Montufar/Hexagro_MBV2.1/README.md

# Hexagro_MBV2.1
Schematic, BOM and PCB layout of V2.1 Motherboard
