Montufar/Hexagro_MBV2.1/motherBoard_V2.xlsx

Sheet: Motherboard
Item | Qty | Reference(s) | Value | LibPart | Footprint | Mouser Code |  | x1
1 | 1 | AFF1 | HDSP-7xxx-A | display:HDSP-7xxx-A | Displays_7-Segment:HDSP-78xx | 630-HDSP-7803-JK000 (https://eu.mouser.com/ProductDetail/Broadcom-Avago/HDSP-7803-JK000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) |  | 1
2 | 6 | C1, C12, C13, C23, C24, C25 | 1uF | device:C | Capacitors_SMD:C_0603 | 81-GRM188C80G105MA1D (https://eu.mouser.com/ProductDetail/Murata-Electronics/GRM188C80G105MA01D) |  | 6
3 | 2 | C2, C3 | 18pF | device:C | Capacitors_SMD:C_0603 | 77-VJ0603A180JXQCBC (https://eu.mouser.com/ProductDetail/Vishay-Vitramon/VJ0603A180JXQCW1BC) |  | 2
4 | 1 | C4 | 680uF | device:CP1 | Capacitors_SMD:CP_Elec_10x10.5 | 667-EEE-FT1V681UP |  | 1
5 | 1 | C5 | 220uF | device:CP1 | Capacitors_SMD:CP_Elec_10x10.5 | 80-EDK227M010A9HAA |  | 1
6 | 6 | C6, C7, C8, C9, C10, C11 | 100nF | device:C | Capacitors_SMD:C_0603 | 603-CC603ZRY5V7BB104 (https://eu.mouser.com/ProductDetail/Yageo/CC0603ZRY5V7BB104) |  | 6
7 | 6 | C14, C16, C17, C19, C20, C22 | 1nF | device:C | Capacitors_SMD:C_0603 | 710-885012206034 (https://eu.mouser.com/ProductDetail/Wurth-Electronics/885012206034) |  | 6
8 | 3 | C15, C18, C21 | 10nF | device:C | Capacitors_SMD:C_0603 | 710-885012206065 (https://eu.mouser.com/ProductDetail/Wurth-Electronics/885012206065) |  | 3
9 | 1 | CON1 | AVR-ISP-6 | atmel:AVR-ISP-6 | Pin_Headers:Pin_Header_Straight_2x03_Pitch2.54mm | 571-103777-3 (https://eu.mouser.com/ProductDetail/TE-Connectivity-AMP/103777-3) |  | 1
10 | 34 | D1, D6, D7, D8, D9, D10, D11, D12, D13, D14, D15, D16, D17, D18, D19, D20, D21, D22, D23, D24, D25, D26, D27, D28, D29, D30, D31, D32, D34, D35, D36, D38, D39, D40 | LED | device:LED | LEDs:LED_0603 | 710-150060RS75000 |  | 34
11 | 1 | D2 | D_TVS_24V | device:D_TVS | Diodes_SMD:D_SMA | - |  | 1
12 | 3 | D3, D4, D5 | D | device:D | Diodes_SMD:D_SMA | 755-RB080LAM-30TR (https://eu.mouser.com/ProductDetail/ROHM-Semiconductor/RB080LAM-30TR) |  | 3
13 | 4 | F1, F2, F3, F7 | F | device:Fuse | Fuse_Holders_and_Fuses:Fuseholder5x20_horiz_open_universal_Type-III | 693-0031.8201 |  | 4
14 | 1 | F5 | 1A | device:Fuse | Fuse_Holders_and_Fuses:Fuse_SMD1206_Reflow | 650-0603SFS100F/32-2 (https://eu.mouser.com/ProductDetail/Littelfuse/0603SFS100F-32-2) |  | 1
15 | 1 | F6 | 3A | device:Fuse | Fuse_Holders_and_Fuses:Fuse_SMD1206_Reflow | 650-0603SFS300F/32-2 (https://eu.mouser.com/ProductDetail/Littelfuse/0603SFS300F-32-2) |  | 1
16 | 1 | J1 | Conn_LEDs | conn:Conn_02x02_Counter_Clockwise | Connectors_Molex:Molex_MiniFit-JR-5569-04A2_2x02x4.20mm_Angled | 538-39-30-0040 (https://eu.mouser.com/ProductDetail/Molex/39-30-0040) | 538-39-01-2046 | 1
17 | 2 | J2, J4 | Conn_Hyd_1 | conn:Conn_02x07_Top_Bottom | Connectors_Molex:Molex_MiniFit-JR-5569-14A2_2x07x4.20mm_Angled | 538-39-30-1140 (https://eu.mouser.com/ProductDetail/Molex/39-30-1140) | 538-15-06-0146 | 2
18 | 1 | J3 | Conn_RPi3 | conn:Conn_02x20_Odd_Even | Pin_Headers:Pin_Header_Straight_2x20_Pitch2.54mm | 517-929975-01-20 (https://eu.mouser.com/ProductDetail/3M-Electronic-Solutions-Division/929975-01-20) |  | 1
19 | 2 | J5, J9 | Conn_01x03 | conn:Conn_01x03 | Pin_Headers:Pin_Header_Straight_1x03_Pitch2.54mm | 571-2828343 |  | 2
20 | 8 | J6, J7, J8, J10, J11, J12, M1, JQ5 | Conn_01x02 | conn:Conn_01x02 | Pin_Headers:Pin_Header_Straight_2x01_Pitch2.54mm | 571-282834-2 |  | 8
21 | 1 | L1 | 33uH | device:L | Inductors_SMD:L_12x12mm_h8mm | 994-MSS1278-333MLD (https://eu.mouser.com/ProductDetail/Coilcraft/MSS1278-333MLD) |  | 1
22 | 3 | Q1, Q2, Q3 | BSS138 | transistors:BSS138 | TO_SOT_Packages_SMD:SOT-23 | 771-BSS138P215 (https://eu.mouser.com/ProductDetail/Nexperia/BSS138P215?qs=sGAEpiMZZMuW3D0gRv32gn9EhwRhF9cb) |  | 3
23 | 1 | Q4 | 2N7000 | transistors:2N7000 | TO_SOT_Packages_SMD:SOT-23 | 621-DMN2230UQ-7 (https://eu.mouser.com/ProductDetail/Diodes-Incorporated/DMN2230UQ-7) |  | 1
24 | 1 | Q5 | TEPT4400 | opto:BP103B | Pin_Headers:Pin_Header_Straight_2x01_Pitch2.54mm | 782-TEPT4400 |  | 1
25 | 3 | R1 | 10m | device:R | Arduino:OARS1 | 66-OARS3R010FLF (https://eu.mouser.com/ProductDetail/IRC-TT-Electronics/OARS3R010FLF) |  | 3
26 | 2 | R2, R3 | 50m | device:R | Arduino:OARS1 | 660-SL3TTE50L0F (https://eu.mouser.com/ProductDetail/KOA-Speer/SL3TTE50L0F) |  | 2
27 | 27 | R4, R19, R20, R21, R22, R23, R24, R25, R26, R27, R28, R29, R30, R31, R32, R33, R34, R35, R36, R39, R40, R42, R43, R59, R61, R62, R63 | 2k2 | device:R | Resistors_SMD:R_0603 | 660-SG73G1JTTD2201D (https://eu.mouser.com/ProductDetail/KOA-Speer/SG73G1JTTD2201D) |  | 27
28 | 29 | R5, R6, R7, R8, R9, R10, R11, R37, R38, R44, R46, R49, R50, R51, R65, R66, R67, R68, R69, R70, R71, R73, R74, R75, R76, R77, R78, R79, R80 | 10k | device:R | Resistors_SMD:R_0603 | 71-RCG060310K0JNEA (https://eu.mouser.com/ProductDetail/Vishay-Draloric/RCG060310K0JNEA) |  | 29
29 | 15 | R12, R13, R14, R15, R16, R17, R18, R48, R52, R53, R54, R55, R56, R57, R58 | 330 | device:R | Resistors_SMD:R_0603 | 755-ESR03EZPJ331 (https://eu.mouser.com/ProductDetail/ROHM-Semiconductor/ESR03EZPJ331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) |  | 15
30 | 3 | R41, R60, R64 | 1M | device:R | Resistors_SMD:R_0603 | 667-ERJ-PA3J105V (https://eu.mouser.com/ProductDetail/Panasonic/ERJ-PA3J105V) |  | 3
31 | 2 | R45, R47 | 100 | device:R | Resistors_SMD:R_0603 | 603-AC0603FR-13100RL (https://eu.mouser.com/ProductDetail/Yageo/AC0603FR-13100RL) |  | 2
32 | 1 | R72 | 22k | device:R | Resistors_SMD:R_0603 | 71-RCG060322K0JNEA (https://eu.mouser.com/ProductDetail/Vishay-Draloric/RCG060322K0JNEA) |  | 1
33 | 3 | R81, R82, R83 | 100k | device:R | Resistors_SMD:R_0603 | 71-RCA0603100KJNEC (https://eu.mouser.com/ProductDetail/Vishay-Draloric/RCA0603100KJNEC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) |  | 3
34 | 3 | SW1, SW2, SW3 | SW_Push | switches:SW_Push | Buttons_Switches_SMD:SW_SPST_B3SL-1002P | 653-B3SL-1002P |  | 3
35 | 4 | TH1, TH2, TH3, TH4 | Thermistor_NTC | device:Thermistor_NTC | Resistors_SMD:R_0603 | 81-NCP18XH103J03RB (https://eu.mouser.com/ProductDetail/Murata-Electronics/NCP18XH103J03RB) |  | 4
36 | 1 | U2 | MAX485E | interface:MAX485E | Housings_SOIC:SO-8_5.3x6.2mm_Pitch1.27mm | 584-LTC1481CS8#PBF (https://eu.mouser.com/ProductDetail/Analog-Devices/LTC1481CS8PBF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) |  | 1
37 | 3 | U3, U4, U5 | TLE6230GP | motherBoard_V2.0-cache:TLE6230GP | Arduino:PG-DSO-36 | 726-TLE6230GP (https://eu.mouser.com/ProductDetail/Infineon-Technologies/TLE6230GP) |  | 3
38 | 1 | U6 | ATMEGA2560-16AU | atmel:ATMEGA2560-16AU | Housings_QFP:TQFP-100_14x14mm_Pitch0.5mm | 556-ATMEGA2560-16AU (https://eu.mouser.com/ProductDetail/Microchip-Technology-Atmel/ATmega2560-16AU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) |  | 1
39 | 1 | U7 | LM2596S-5 | Regulator_Switching:LM2596S-5 | TO_SOT_Packages_SMD:TO-263-5_TabPin3 | 926-LM2596SX-5.0NOPB (https://eu.mouser.com/ProductDetail/Texas-Instruments/LM2596SX-50-NOPB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) |  | 1
40 | 1 | U8 | INA4180A2IPWR | motherBoard_V2.0-cache:INA4180 | Housings_SSOP:TSSOP-14_4.4x5mm_Pitch0.65mm | 595-INA4180A2IPWR |  | 1
41 | 1 | U9 | MCP6004 | linear:MCP6004 | Housings_SOIC:SOIC-14_3.9x8.7mm_Pitch1.27mm | 579-MCP6004T-I/SL (https://eu.mouser.com/ProductDetail/Microchip-Technology/MCP6004T-I-SL) |  | 1
42 | 3 | U10, U11, U12 | AD8495 | motherBoard_V2.0-cache:AD8495 | Housings_SSOP:MSOP-8_3x3mm_Pitch0.65mm | 584-AD8495ARMZ-R7 (https://eu.mouser.com/ProductDetail/Analog-Devices/AD8495ARMZ-R7?qs=sGAEpiMZZMv9Q1JI0Mo%2ftbIZZET%2feT7H) |  | 3
43 | 1 | Y1 | 16 MHz | device:Crystal | Crystals:Crystal_SMD_0603-2pin_6.0x3.5mm | 520-16.0-18-23G-JGNT (https://eu.mouser.com/ProductDetail/ECS/ECS-160-18-23G-JGN-TR) |  | 1
44 | 3 | 1 A Fuse |  |  |  | 530-5VT1-R (https://eu.mouser.com/ProductDetail/Bel-Fuse/5VT-1-R) |  | 3
45 | 1 | 8 A Fuse |  |  |  | 530-5MF8-R (https://eu.mouser.com/ProductDetail/Bel-Fuse/5MF-8-R) |  | 1
46 | 1 | Raspberry Pi 3 |  |  |  | 358-6010602 (https://eu.mouser.com/ProductDetail/Raspberry-Pi/6010602) |  | 1
47 | 1 | uSD 32 Gb |  |  |  | - |  | 1
48 | 1 | fan |  |  |  | 562-FAD1-06020BSHW11 |  | 1
49 | 1 | box |  |  |  | 616-82407-01 (https://eu.mouser.com/ProductDetail/PacTec/82407-01-PT-10-ALUM) |  | 1
50 | 1 | dht11/22 |  |  |  | 485-386 (https://eu.mouser.com/ProductDetail/Adafruit/386?qs=sGAEpiMZZMsMyYRRhGMFNh01bQ8voJljBK9gPXpRcgg%3d) |  | 1
51 | 3 | thermocouples |  |  |  | 615-TP29 |  | 3
52 | 3 | FSR |  |  |  | 588-FSR01CE (https://eu.mouser.com/ProductDetail/Ohmite/FSR01CE) |  | 3
53 | 1 | Water pressure sensor |  |  |  | - |  | 1
54 | 1 | Minifit Jr 4 |  |  |  | 538-39-01-2040 |  | 1
55 | 2 | Minifit Jr 14 |  |  |  | 538-39-01-2140 (https://eu.mouser.com/ProductDetail/Molex/39-01-2140) |  | 2
56 | 30 | crimp male |  |  |  | 538-39-00-0078 (https://eu.mouser.com/ProductDetail/Molex/39-00-0078) |  | 30
57 | 1 | main switch |  |  |  | 691-DA100-BB-B |  | 1
 | 1 | solder paste |  |  |  | 474-TOL-12878 |  | 1

Sheet: LED Driver
Item | Qty | Reference(s) | Value | LibPart | Footprint | Mouser Code | x1
1 | 3 | C1, C2, C3 | 1uF | device:CP1 | Capacitors_SMD:C_0603 | 81-GRM188C80G105MA1D (https://eu.mouser.com/ProductDetail/Murata-Electronics/GRM188C80G105MA01D) | 3
2 | 3 | C4, C5, C6 | 3.3uF | device:CP1 | Capacitors_SMD:C_0603 | 810-C1608JB1V335M08C | 3
3 | 1 | C7 | 10uF | device:CP1 | Capacitors_Tantalum_SMD:CP_Tantalum_Case-R_EIA-2012-12_Reflow | 74-TMCMC1V106MTRF | 1
4 | 3 | C8, C11, C12 | 100nF | device:C | Capacitors_SMD:C_0603 | 603-CC603ZRY5V7BB104 (https://eu.mouser.com/ProductDetail/Yageo/CC0603ZRY5V7BB104) | 3
5 | 1 | C9 | 22nF | device:C | Capacitors_SMD:C_0603 | 710-885012206042 (https://eu.mouser.com/ProductDetail/Wurth-Electronics/885012206042) | 1
6 | 1 | C10 | 4.7uF | device:C | Capacitors_SMD:C_0603 | 810-CGB3B1X5R1A475MC (https://eu.mouser.com/ProductDetail/TDK/CGB3B1X5R1A475M055AC?qs=sGAEpiMZZMs0AnBnWHyRQAvc2asflqO5yVUq4hNDKGE%3d) | 1
7 | 1 | CON1 | AVR-ISP-6 | atmel:AVR-ISP-6 | Pin_Headers:Pin_Header_Straight_2x03_Pitch1.27mm | 649-67997-410HLF | 1
8 | 5 | D1, D2, D3, D4, D10 | D_Schottky | device:D_Schottky | Diodes_SMD:D_SOD-123 | 511-STPS2H100ZF (https://eu.mouser.com/ProductDetail/STMicroelectronics/STPS2H100ZF) | 5
9 | 1 | D5 | D_TVS | device:D_Zener | Diodes_SMD:D_SOD-123F | 652-SMAJ24CA-H | 1
10 | 4 | D6, D7, D8, D9 | NUP2105L | device:D_TVS_x2_AAC | TO_SOT_Packages_SMD:SOT-23 | 863-NUP2105LT1G (https://www.mouser.it/ProductDetail/ON-Semiconductor/NUP2105LT1G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) | 4
11 | 4 | F1, F2, F3, F4 | 0.5 A | device:Fuse | Resistors_SMD:R_0603 | 650-0603SFS100F/32-2 (https://www.mouser.it/ProductDetail/Littelfuse/0603SFS100F-32-2) | 4
12 | 1 | IC1 | ATMEGA48-A | HexCell-cache:ATMEGA48-A | Housings_QFP:TQFP-32_7x7mm_Pitch0.8mm | 556-ATMEGA48PB-AU (https://www.mouser.it/ProductDetail/Microchip-Technology-Atmel/ATMEGA48PB-AU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) | 1
13 | 1 | J1 | Conn_02x02_Top_Bottom | conn:Conn_02x02_Top_Bottom | Pin_Headers:Pin_Header_Straight_2x02_Pitch2.54mm | 649-67997-410HLF | 1
14 | 1 | J2 | Conn_02x04_Odd_Even | conn:Conn_02x04_Odd_Even | Pin_Headers:Pin_Header_Straight_2x04_Pitch2.54mm | 649-67997-410HLF | 1
15 | 2 | L1, L2 | 33nH | HexCell-cache:INDUCTOR | Resistors_SMD:R_1206 | 70-ILSB0805ERR33K (https://www.mouser.it/ProductDetail/Vishay-Dale/ILSB0805ERR33K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) | 2
16 | 3 | L3, L4, L5 | 33uH | device:L | Inductors_SMD:L_Abracon_ASPI-3012S | 994-ME3220-333KLB (https://www.mouser.it/ProductDetail/Coilcraft/ME3220-333KLB) | 3
17 | 1 | L6 | 4.7uH | device:L | Inductors_SMD:L_Abracon_ASPI-3012S | 994-ME3220-472MLB (https://www.mouser.it/ProductDetail/Coilcraft/ME3220-472MLB) | 1
18 | 5 | R1, R2, R3, R7, R9 | 10k | device:R | Resistors_SMD:R_0603 | 71-RCG060310K0JNEA (https://eu.mouser.com/ProductDetail/Vishay-Draloric/RCG060310K0JNEA) | 5
19 | 3 | R4, R5, R6 | 300m | device:R | Resistors_SMD:R_0805 | 667-ERJ-6DQJR30V | 3
20 | 1 | R8 | 100R | device:R | Resistors_SMD:R_0603 | 603-AC0603FR-13100RL (https://eu.mouser.com/ProductDetail/Yageo/AC0603FR-13100RL) | 1
21 | 1 | R10 | 28.7k | device:R | Resistors_SMD:R_0603 | 603-RC0603FR-1328K7L (https://www.mouser.it/ProductDetail/Yageo/RC0603FR-1328K7L?qs=sGAEpiMZZMvdGkrng054t8AJgcdMkx7xtkFTZBbxgCA%3d) | 1
22 | 1 | R11 | 150k | device:R | Resistors_SMD:R_0603 | 603-RC0603FR-07150KL (https://www.mouser.it/ProductDetail/Yageo/RC0603FR-07150KL) | 1
23 | 3 | U1, U2, U3 | AL8805 | HexCell-cache:AL8805 | TO_SOT_Packages_SMD:SOT-23-5 | 621-AL8805W5-7 | 3
24 | 1 | U4 | SP485EN-L/TR | HexCell-cache:MAX-485 | Housings_SOIC:SOIC-8_3.9x4.9mm_Pitch1.27mm | 584-LTC1481CS8#PBF (https://eu.mouser.com/ProductDetail/Analog-Devices/LTC1481CS8PBF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) | 1
25 | 1 | U5 | ACT4088 | HexCell-cache:ACT4088 | TO_SOT_Packages_SMD:SOT-23-6 | 107-ACT4088US-T (https://www.mouser.it/ProductDetail/Active-Semi/ACT4088US-T) | 1

Sheet: Shopping
Item | Reference(s) | Value | Mouser Code | Qty
 | AFF1 | 8 Segment Display | 630-HDSP-7803-JK000 (https://eu.mouser.com/ProductDetail/Broadcom-Avago/HDSP-7803-JK000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) | 2
 | C1, C12, C13, C23, C24, C25 | 1uF, 10V, 0603 | 81-GRM18R61A105MA61D (https://eu.mouser.com/ProductDetail/Murata-Electronics/GRM188R61A105MA61D) | 10 | tanks for smart low-sides and LPF for thermocouple circuits
 | C2, C3 | 18pF, 10V, 0603 | 77-VJ0603A180JXQCBC (https://eu.mouser.com/ProductDetail/Vishay-Vitramon/VJ0603A180JXQCW1BC) | 5 | for crystal oscillator
 | C4 | 680uF, 35V, 10x10.2mm | 667-EEE-FT1V681UP | 2 | input capacitor for step-down
 | C5 | 220uF, 10V, 10x10.2mm | 80-EDK227M010A9HAA | 2 | output capacitor for step-down
 | C6, C7, C8, C9, C10, C11 | 100nF, 10V, 0603 | 710-885012206020 (https://eu.mouser.com/ProductDetail/Wurth-Electronics/885012206020) | 10 | bypass for MCU and transceiver
 | C14, C16, C17, C19, C20, C22 | 1nF, 16V, 0603 | 710-885012206034 (https://eu.mouser.com/ProductDetail/Wurth-Electronics/885012206034) | 10 | input filter for thermocouples
 | C15, C18, C21 | 10nF, 25V, 0603 | 710-885012206065 (https://eu.mouser.com/ProductDetail/Wurth-Electronics/885012206065) | 10 | input filter for thermocouples
 | D1, D6, D7, D8, D9, D10, D11, D12, D13, D14, D15, D16, D17, D18, D19, D20, D21, D22, D23, D24, D25, D26, D27, D28, D29, D30, D31, D32, D34, D35, D36, D38, D39, D40 | Indicator LED | 710-150060RS75000 | 50 | indicator LEDs
 | D3, D4, D5 | Schottky, 5A, 30V, SOD-128 | 755-RB080LAM-30TR (https://eu.mouser.com/ProductDetail/ROHM-Semiconductor/RB080LAM-30TR) | 5 | step-down circuit diodes
 | F1, F2, F3, F7 | Fuse Holder, 5x20mm | 693-0031.8201 | 5 | fuse holders
 | F7, F1, F2 | 1A | 530-5VT1-R (https://eu.mouser.com/ProductDetail/Bel-Fuse/5VT-1-R) | 5 | 1A glass fuse 5x20mm
 | F3 | 8A | 530-5MF8-R (https://eu.mouser.com/ProductDetail/Bel-Fuse/5MF-8-R) | 5 | 8A glass fuse 5x20mm
 | F5 | 1A | 650-0603SFS100F/32-2 (https://eu.mouser.com/ProductDetail/Littelfuse/0603SFS100F-32-2) | 3 | step-down input fuse
 | F6 | 3A | 650-0603SFS300F/32-2 (https://eu.mouser.com/ProductDetail/Littelfuse/0603SFS300F-32-2) | 3 | step-down output fuse
 | J1 | Conn_LEDs | 538-39-30-0040 (https://eu.mouser.com/ProductDetail/Molex/39-30-0040) | 2 | minifit jr 2x2 header (male)
 | J2, J4 | Conn_Hyd_1 | 538-39-30-1140 (https://eu.mouser.com/ProductDetail/Molex/39-30-1140) | 4 | minifit jr 2x7 header (male)
 | J1 | Conn_LEDs | 538-39-01-2040 | 2 | minifit jr 2x2 receptacle housing (female)
 | J2, J4 | Conn_Hyd_1 | 538-39-01-2140 (https://eu.mouser.com/ProductDetail/Molex/39-01-2140) | 4 | minifit jr 2x14 receptacle housing (female)
 | J1, J2, J4 | crimp male | 538-39-00-0078 (https://eu.mouser.com/ProductDetail/Molex/39-00-0078) | 50 | minifit jr female crimp
 | J3 | Conn_RPi3 | 517-929975-01-20 (https://eu.mouser.com/ProductDetail/3M-Electronic-Solutions-Division/929975-01-20) | 2 | receptacle for raspberry pi
 | MPU1 | Raspberry Pi 3 | 358-RPI3-MODBP-BULK (https://eu.mouser.com/ProductDetail/Raspberry-Pi/RPI3-MODBP-BULK) | 1 | Raspberry Pi 3 B+
 | J5, J9 | Conn_01x03 | 571-2828343 | 3 | 3 inputs terminal block
 | J6, J7, J8, J10, J11, J12, M1, JQ5 | Conn_01x02 | 571-282834-2 | 10 | 2 inputs terminal block
 | L1 | 33uH, 3.1A, 12.3x12.3mm | 994-MSS1278-333MLD (https://eu.mouser.com/ProductDetail/Coilcraft/MSS1278-333MLD) | 2 | step-down inductor
 | Q1, Q2, Q3 | BSS138 | 771-BSS138P215 (https://eu.mouser.com/ProductDetail/Nexperia/BSS138P215?qs=sGAEpiMZZMuW3D0gRv32gn9EhwRhF9cb) | 5 | for 3.3V-to-5V level circuits
 | Q4 | DMN2230UQ-7 | 621-DMN2230UQ-7 (https://eu.mouser.com/ProductDetail/Diodes-Incorporated/DMN2230UQ-7) | 2 | fan driver MOSFET 20V N-Ch Enh FET 20Vdss 2.0A 7A 600mW
 | Q5 | TEPT4400 | 782-TEPT4400 | 2 | Ambient light sensor
 | R1 | 10m, 3W | 66-OARS3R010FLF (https://eu.mouser.com/ProductDetail/IRC-TT-Electronics/OARS3R010FLF) | 5 | current sense resistor, 10mOhm
 | R2, R3 | 50m | 660-SL3TTE50L0F (https://eu.mouser.com/ProductDetail/KOA-Speer/SL3TTE50L0F) | 2 | current sense resistor, 50mOhm, not correct size
 | R4, R19, R20, R21, R22, R23, R24, R25, R26, R27, R28, R29, R30, R31, R32, R33, R34, R35, R36, R39, R40, R42, R43, R59, R61, R62, R63 | 2k2 | 660-SG73G1JTTD2201D (https://eu.mouser.com/ProductDetail/KOA-Speer/SG73G1JTTD2201D) | 50 | indicator LED resistors for 24V signals
 | R5, R6, R7, R8, R9, R10, R11, R37, R38, R44, R46, R49, R50, R51, R65, R66, R67, R68, R69, R70, R71, R73, R74, R75, R76, R77, R78, R79, R80 | 10k | 71-RCG060310K0JNEA (https://eu.mouser.com/ProductDetail/Vishay-Draloric/RCG060310K0JNEA) | 50 | pull-up and pull-downs
 | R12, R13, R14, R15, R16, R17, R18, R48, R52, R53, R54, R55, R56, R57, R58 | 330 | 755-ESR03EZPJ331 (https://eu.mouser.com/ProductDetail/ROHM-Semiconductor/ESR03EZPJ331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) | 20 | indicator LED resistors for 5V signals
 | R41, R60, R64 | 1M | 667-ERJ-PA3J105V (https://eu.mouser.com/ProductDetail/Panasonic/ERJ-PA3J105V) | 5 | for thermocouple circuits
 | R45, R47 | 100 | 71-RCG0603100RFKEA (https://eu.mouser.com/ProductDetail/Vishay-Draloric/RCG0603100RFKEA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) | 5 | for fan driver and transceiver
 | R72 | 22k | 71-RCG060322K0JNEA (https://eu.mouser.com/ProductDetail/Vishay-Draloric/RCG060322K0JNEA) | 2 | for light sensor circuit
 | R81, R82, R83 | 100k | 71-RCA0603100KJNEC (https://eu.mouser.com/ProductDetail/Vishay-Draloric/RCA0603100KJNEC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) | 5 | LPF for thernocouple circuits
 | SW1, SW2, SW3 | SW_Push | 653-B3SL-1002P | 5 | buttons for test control
 | TH1, TH2, TH3, TH4 | Thermistor_NTC | 81-NCP18XH103J03RB (https://eu.mouser.com/ProductDetail/Murata-Electronics/NCP18XH103J03RB) | 5 | thermistors
 | U2 | SP485EN-L/TR | 701-SP485EN-L/TR (https://eu.mouser.com/ProductDetail/Exar/SP485EN-L-TR) | 2 | RS-485 transceiver
 | U3, U4, U5 | TLE6230GP | 726-TLE6230GP (https://eu.mouser.com/ProductDetail/Infineon-Technologies/TLE6230GP) | 6 | smart low-side drivers
 | U6 | ATMEGA2560-16AU | 556-ATMEGA2560-16AU (https://eu.mouser.com/ProductDetail/Microchip-Technology-Atmel/ATmega2560-16AU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) | 3 | main MCU
 | U7 | LM2596S-5 | 926-LM2596SX-5.0NOPB (https://eu.mouser.com/ProductDetail/Texas-Instruments/LM2596SX-50-NOPB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) | 2 | step-down driver
 | U8 | INA4180A2IPWR | 595-INA4180A2IPWR | 2 | current sense circuit
 | U9 | MCP6004 | 579-MCP6004T-I/SL (https://eu.mouser.com/ProductDetail/Microchip-Technology/MCP6004T-I-SL) | 2 | signal conditioning for sensors
 | U10, U11, U12 | AD8495 | 584-AD8495ARMZ-R7 (https://eu.mouser.com/ProductDetail/Analog-Devices/AD8495ARMZ-R7?qs=sGAEpiMZZMv9Q1JI0Mo%2ftbIZZET%2feT7H) | 5 | thermocouple instrumentation amplifier
 | Y1 | 16 MHz | 520-16.0-18-23G-JGNT (https://eu.mouser.com/ProductDetail/ECS/ECS-160-18-23G-JGN-TR) | 2 | crystal oscillator
 | A1 | fan | 562-FAD1-06020BSHW11 | 2 | 60x60x20mm fan, 5V, 900mW (0.18A) BLDC
 | box |  | 616-82407-01 (https://eu.mouser.com/ProductDetail/PacTec/82407-01-PT-10-ALUM) | 1 | box
 | dht11/22 |  | 485-386 (https://eu.mouser.com/ProductDetail/Adafruit/386?qs=sGAEpiMZZMsMyYRRhGMFNh01bQ8voJljBK9gPXpRcgg%3d) | 1 | DHT11
 | thermocouples |  | 615-TP29 | 1 | thermocouple
 | FSR |  | 588-FSR01CE (https://eu.mouser.com/ProductDetail/Ohmite/FSR01CE) | 1 | FSR
 | main switch |  | 691-DA100-BB-B | 1 | 10A switch
 | solder paste |  | 474-TOL-12878 | 1 | solder paste
 | C1, C2, C3 | 1uF, 50V, 0603 | 963-UMK107ABJ105KAHT (https://eu.mouser.com/ProductDetail/Taiyo-Yuden/UMK107ABJ105KAHT) | 30 | capacitor parallel to power LEDs
 | C4, C5, C6 | 3.3uF, 35V, 0603 | 810-C1608JB1V335M08C | 30 | input capacitor for LED drivers
 | C7 | 10uF - 35V - 2212 | 74-TMCMC1V106MTRF | 10 | input capacitor for step-down
 | C8, C11, C12 | 100nF, 10V, 0603 | 710-885012206020 (https://eu.mouser.com/ProductDetail/Wurth-Electronics/885012206020) | 30 | bypass for MCU and transceiver
 | C9 | 22nF, 16V, 0603 | 710-885012206042 (https://eu.mouser.com/ProductDetail/Wurth-Electronics/885012206042) | 10 | bootstrap for step-down
 | C10 | 4.7uF, 10V, 0603 | 810-CGB3B1X5R1A475MC (https://eu.mouser.com/ProductDetail/TDK/CGB3B1X5R1A475M055AC?qs=sGAEpiMZZMs0AnBnWHyRQAvc2asflqO5yVUq4hNDKGE%3d) | 10 | output capacitor for step-down
 | D1, D2, D3, D4, D10 | D_Schottky - 2A - 100V | 511-STPS2H100ZF (https://eu.mouser.com/ProductDetail/STMicroelectronics/STPS2H100ZF) | 50 | freewheeling diodes, safety input diode and step-down diode
 | D5 | D TVS - 24V - 10A | 652-SMAJ24CA-H | 10 | tvs for 24V input
 | D6, D7, D8, D9 | NUP2105L D TVS - 8A - CAN | 511-ESDCAN24-2BLY (https://eu.mouser.com/ProductDetail/STMicroelectronics/ESDCAN24-2BLY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) | 30 | tvs for the other signals
 | F1, F2, F3, F4 | 0.5 A | 650-0603SFS100F/32-2 (https://www.mouser.it/ProductDetail/Littelfuse/0603SFS100F-32-2) | 30 | LED driver and step-down fuses
 | IC1 | ATMEGA48-A | 556-ATMEGA48PB-AU (https://www.mouser.it/ProductDetail/Microchip-Technology-Atmel/ATMEGA48PB-AU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) | 10 | MCU
 | L1, L2 | 33nH | 70-ILSB0805ERR33K (https://www.mouser.it/ProductDetail/Vishay-Dale/ILSB0805ERR33K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) | 10 | ground bypass
 | L3, L4, L5 | 33uH | 994-ME3220-333KLB (https://www.mouser.it/ProductDetail/Coilcraft/ME3220-333KLB) | 30 | 0.53A inductor for drivers
 | L6 | 4.7uH | 994-ME3220-472MLB (https://www.mouser.it/ProductDetail/Coilcraft/ME3220-472MLB) | 10 | 1.3A inductor for step-down regulator
 | R1, R2, R3, R7, R9 | 10k | 71-RCG060310K0JNEA (https://eu.mouser.com/ProductDetail/Vishay-Draloric/RCG060310K0JNEA) | 50 | pull-up and pull-downs
 | R4, R5, R6 | 300m | 667-ERJ-6DQJR30V | 30 | current sense resistors, 0.5W
 | R8 | 100R | 71-RCG0603100RFKEA (https://eu.mouser.com/ProductDetail/Vishay-Draloric/RCG0603100RFKEA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) | 10 | transceiver terminator resistor
 | R10 | 28.7k | 603-RC0603FR-1328K7L (https://www.mouser.it/ProductDetail/Yageo/RC0603FR-1328K7L?qs=sGAEpiMZZMvdGkrng054t8AJgcdMkx7xtkFTZBbxgCA%3d) | 10 | feedback for step-down
 | R11 | 150k | 603-RC0603FR-07150KL (https://www.mouser.it/ProductDetail/Yageo/RC0603FR-07150KL) | 10 | feedback for step-down
 | U1, U2, U3 | AL8805 | 621-AL8805W5-7 | 30 | LED driver IC
 | U4 | SP485EN-L/TR | 701-SP485EN-L/TR (https://eu.mouser.com/ProductDetail/Exar/SP485EN-L-TR) | 10 | transceiver IC
 | U5 | ACT4088 | 107-ACT4088US-T (https://www.mouser.it/ProductDetail/Active-Semi/ACT4088US-T) | 10 | step-down regulator IC
 |  | C-GRID III CRIMP | 538-90119-2109 | 100
 |  | 2x2 C-GRID HOUSING | 538-90143-0004 | 10
 |  | 2x4 C-GRID HOUSING | 538-90143-0008 | 10
 |  | Pin Header - 40 | 855-M20-9762046 | 5 | pin headers
 |  | solder kit | 474-KIT-14637 (https://eu.mouser.com/ProductDetail/SparkFun/KIT-14637) | 1
 |  | solder paste | 474-TOL-12878 | 1 | solder paste
