Montufar/Hexagro_MBV2.1/motherBoard_V2.1.kicad_pcb

## KiCad design motherBoard_V2.1.kicad_pcb (2020-04-22)

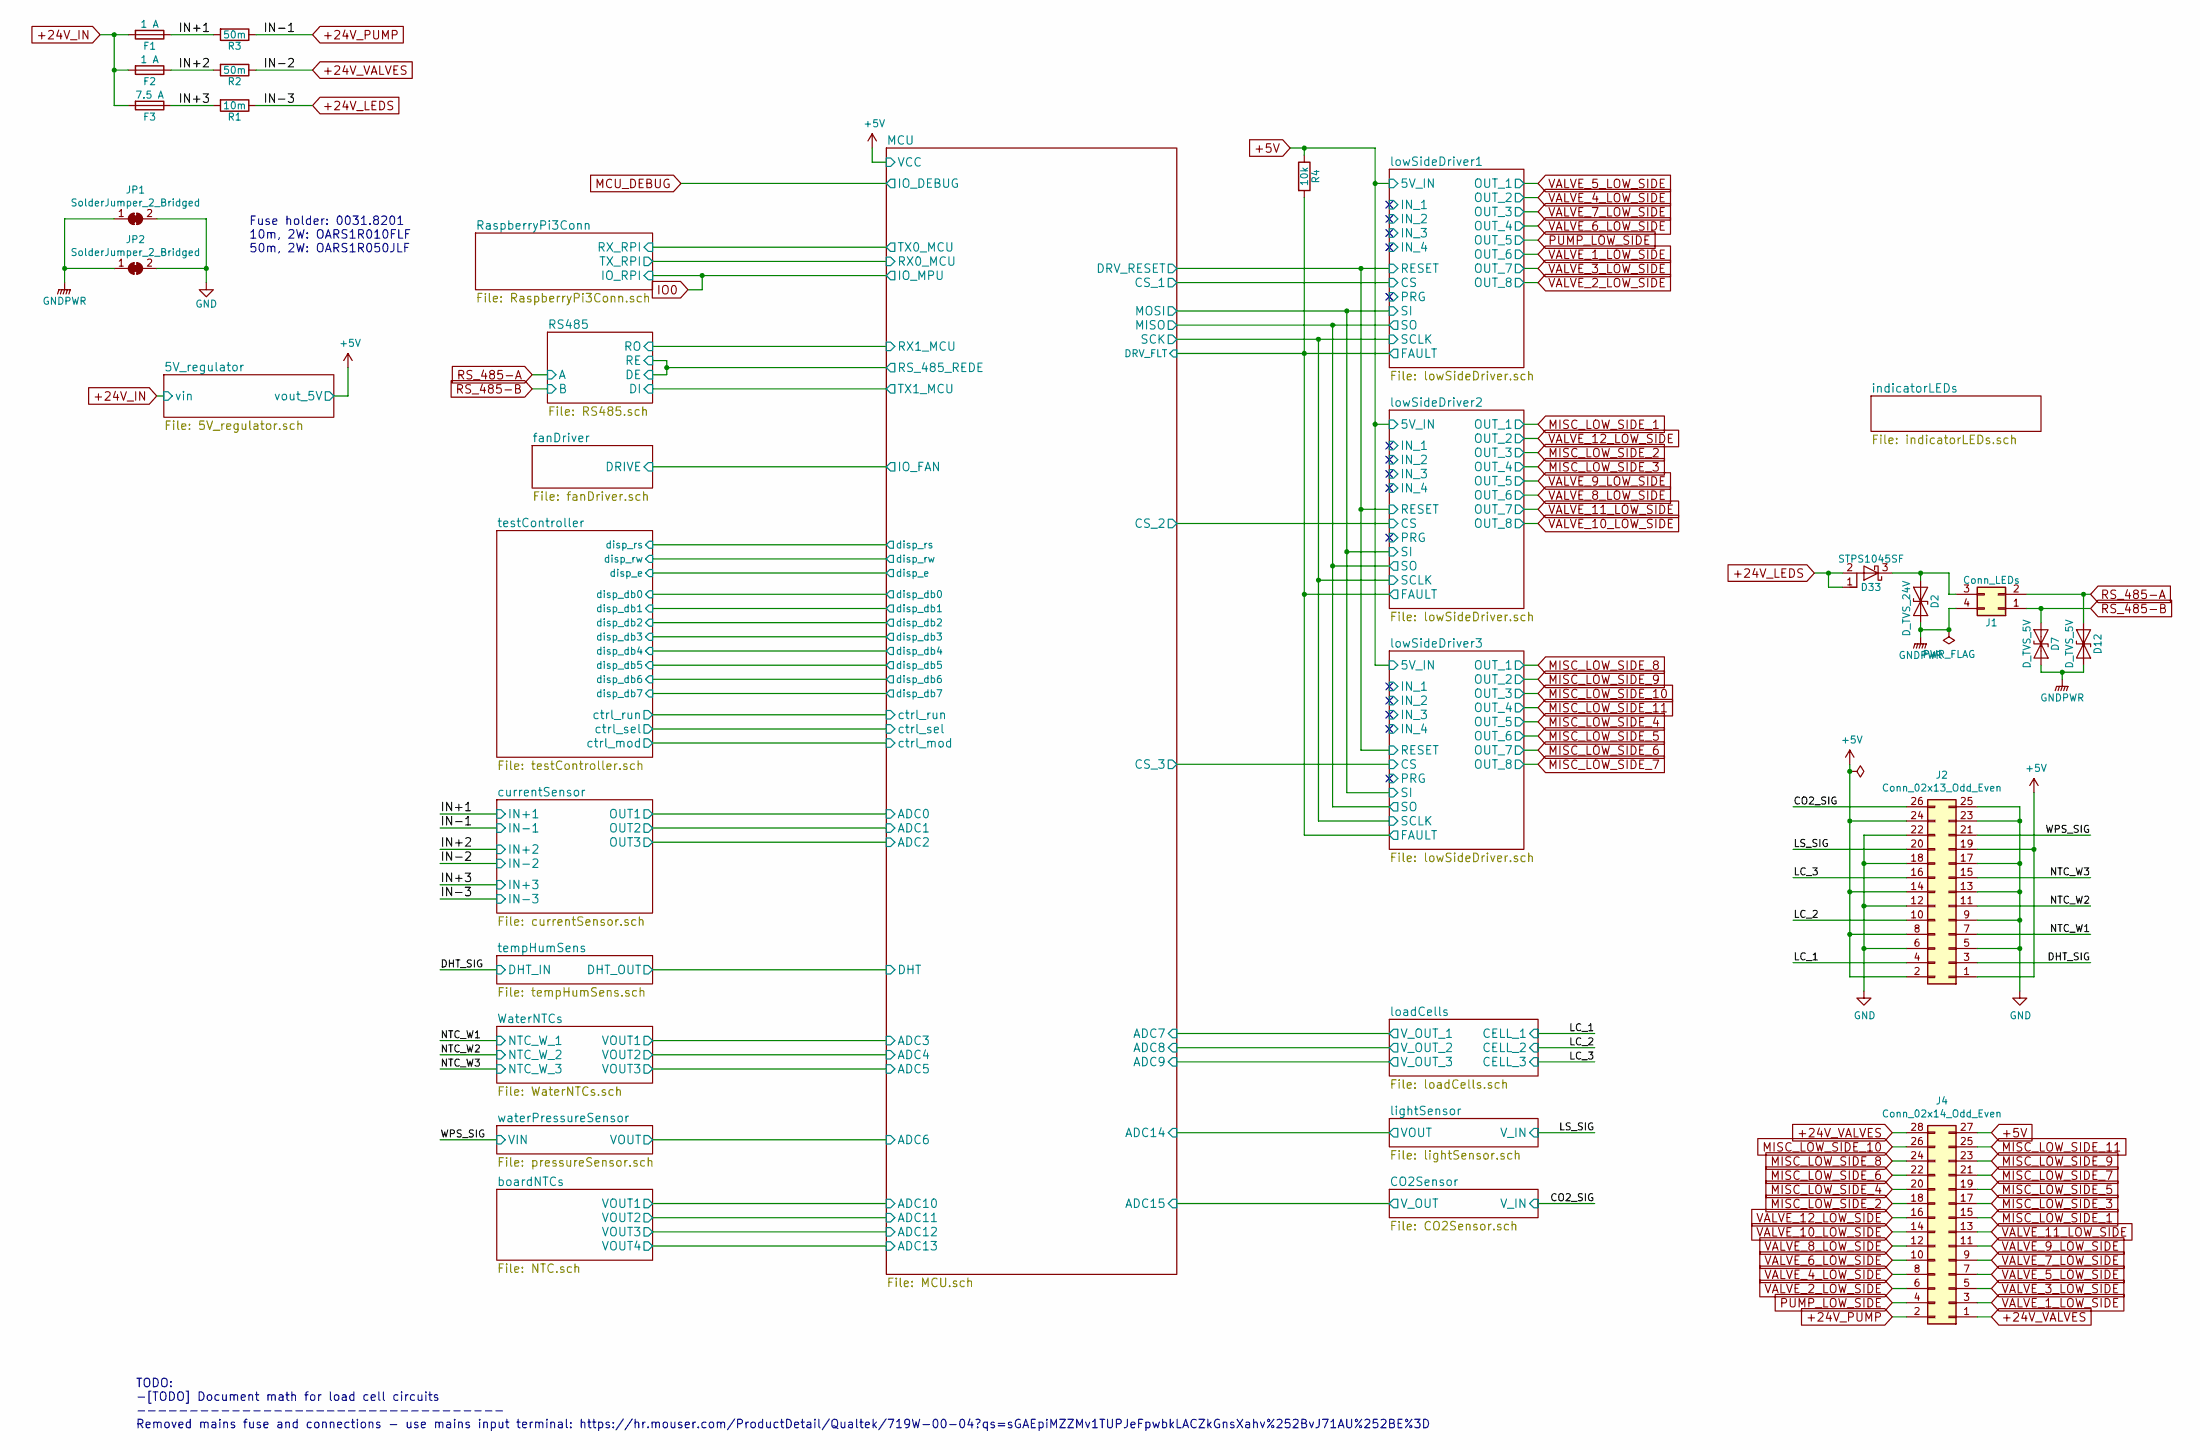
[picture p1: schematic motherBoard_V2.1.sch]

Parts:
D2: D_TVS_24V; D_SMA
D7, D12: D_TVS_5V; D_SMA
D33: STPS1045SF; TO-277A
F1, F2: 1 A; Fuseholder_Cylinder-5x20mm_Schurter_0031_8201_Horizontal_Op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
F3: 7.5 A; Fuseholder_Cylinder-5x20mm_Schurter_0031_8201_Horizontal_Op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
J1: Conn_LEDs; Molex_Mini-Fit_Jr_5566-04A_2x02_P4.20mm_Vertical
J2: Conn_02x13_Odd_Even; PinHeader_2x13_P2.54mm_Vertical
J4: Conn_02x14_Odd_Even; PinHeader_2x14_P2.54mm_Vertical
JP1, JP2: SolderJumper_2_Bridged; SolderJumper-2_P1.3mm_Bridged2Bar_Pad1.0x1.5mm
R1: 10m; OARS1
R2, R3: 50m; OARS1
R4: 10k; R_0603_1608Metric

Connections:
+5V: J2.1, J2.2, J2.8, J2.14, J2.19, J2.24, J4.27, R4.1; also elsewhere on the board
+24V_IN: F1.2, F2.2, F3.2; also elsewhere on the board
+24V_LEDS: D33.1 (A), D33.2 (A), R1.1; also elsewhere on the board
+24V_PUMP: J4.2, R3.1; also elsewhere on the board
+24V_VALVES: J4.1, J4.28, R2.1; also elsewhere on the board
/CO2_SIG: J2.26; also elsewhere on the board
/DHT_SIG: J2.3; also elsewhere on the board
/IN+1: F1.1, R3.2; also elsewhere on the board
/IN+2: F2.1, R2.2; also elsewhere on the board
/IN+3: F3.1, R1.2; also elsewhere on the board
/LC_1: J2.4; also elsewhere on the board
/LC_2: J2.10; also elsewhere on the board
/LC_3: J2.16; also elsewhere on the board
/LS_SIG: J2.20; also elsewhere on the board
/MCU/DRV_FLT: R4.2; also elsewhere on the board
/NTC_W1: J2.7; also elsewhere on the board
/NTC_W2: J2.11; also elsewhere on the board
/NTC_W3: J2.15; also elsewhere on the board
/WPS_SIG: J2.21; also elsewhere on the board
GND: J2.5, J2.6, J2.9, J2.12, J2.13, J2.17, J2.18, J2.22, J2.23, J2.25, JP1.2 (B), JP2.2 (B); also elsewhere on the board
GNDPWR: D2.2 (A2), D7.2 (A2), D12.2 (A2), J1.4, JP1.1 (A), JP2.1 (A); also elsewhere on the board
MISC_LOW_SIDE_1: J4.15; also elsewhere on the board
MISC_LOW_SIDE_2: J4.18; also elsewhere on the board
MISC_LOW_SIDE_3: J4.17; also elsewhere on the board
MISC_LOW_SIDE_4: J4.20; also elsewhere on the board
MISC_LOW_SIDE_5: J4.19; also elsewhere on the board
MISC_LOW_SIDE_6: J4.22; also elsewhere on the board
MISC_LOW_SIDE_7: J4.21; also elsewhere on the board
MISC_LOW_SIDE_8: J4.24; also elsewhere on the board
MISC_LOW_SIDE_9: J4.23; also elsewhere on the board
MISC_LOW_SIDE_10: J4.26; also elsewhere on the board
MISC_LOW_SIDE_11: J4.25; also elsewhere on the board
unnamed: D2.1 (A1), D33.3 (K), J1.3
PUMP_LOW_SIDE: J4.4; also elsewhere on the board
RS_485-A: D12.1 (A1), J1.2; also elsewhere on the board
RS_485-B: D7.1 (A1), J1.1; also elsewhere on the board
VALVE_1_LOW_SIDE: J4.3; also elsewhere on the board
VALVE_2_LOW_SIDE: J4.6; also elsewhere on the board
VALVE_3_LOW_SIDE: J4.5; also elsewhere on the board
VALVE_4_LOW_SIDE: J4.8; also elsewhere on the board
VALVE_5_LOW_SIDE: J4.7; also elsewhere on the board
VALVE_6_LOW_SIDE: J4.10; also elsewhere on the board
VALVE_7_LOW_SIDE: J4.9; also elsewhere on the board
VALVE_8_LOW_SIDE: J4.12; also elsewhere on the board
VALVE_9_LOW_SIDE: J4.11; also elsewhere on the board
VALVE_10_LOW_SIDE: J4.14; also elsewhere on the board
VALVE_11_LOW_SIDE: J4.13; also elsewhere on the board
VALVE_12_LOW_SIDE: J4.16; also elsewhere on the board

Notes on the sheet:
Fuse holder: 0031.8201 10m, 2W: OARS1R010FLF 50m, 2W: OARS1R050JLF
TODO: -[TODO] Document math for load cell circuits ----------------------------------- Removed mains fuse and connections - use mains input terminal: https://hr.mouser.com/ProductDetail/Qualtek/719W-00-04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

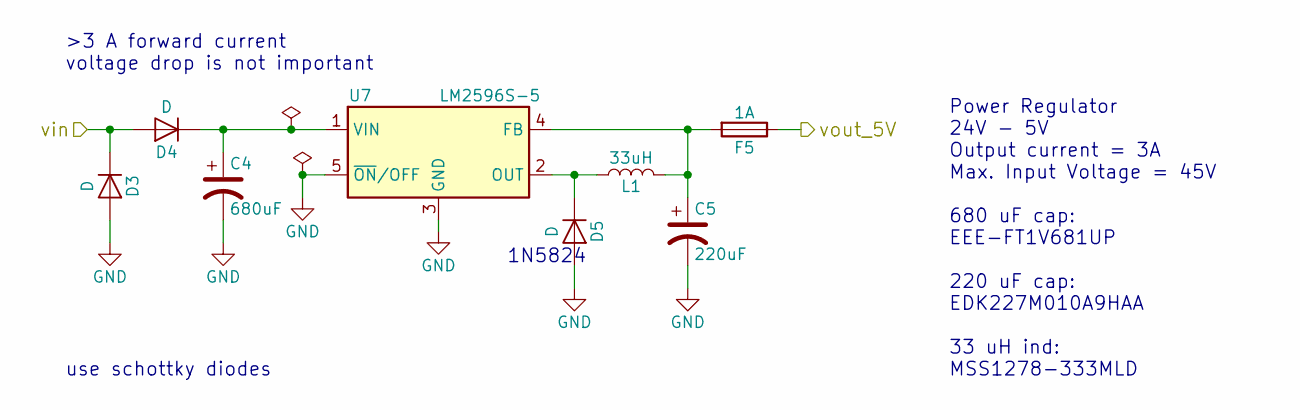
[picture p2: schematic 5V_regulator.sch]

Parts:
C4: 680uF; CP_Elec_10x10.5
C5: 220uF; CP_Elec_10x10.5
D3, D4, D5: D; D_SMA
F5: 1A; Fuse_1206_3216Metric
L1: 33uH; L_12x12mm_H8mm
U7: LM2596S-5; TO-263-5_TabPin3

Connections:
+5V: F5.1; also elsewhere on the board
+24V_IN: D3.1 (K), D4.2 (A); also elsewhere on the board
GND: C4.2, C5.2, D3.2 (A), D5.2 (A), U7.3 (GND), U7.5 (~ON~/OFF); also elsewhere on the board
unnamed: C4.1, D4.1 (K), U7.1 (VIN)
unnamed: C5.1, F5.2, L1.2, U7.4 (FB)
unnamed: D5.1 (K), L1.1, U7.2 (OUT)

Notes on the sheet:
Power Regulator 24V - 5V Output current = 3A Max. Input Voltage = 45V 680 uF cap: EEE-FT1V681UP 220 uF cap: EDK227M010A9HAA 33 uH ind: MSS1278-333MLD
use schottky diodes
1N5824
>3 A forward current voltage drop is not important

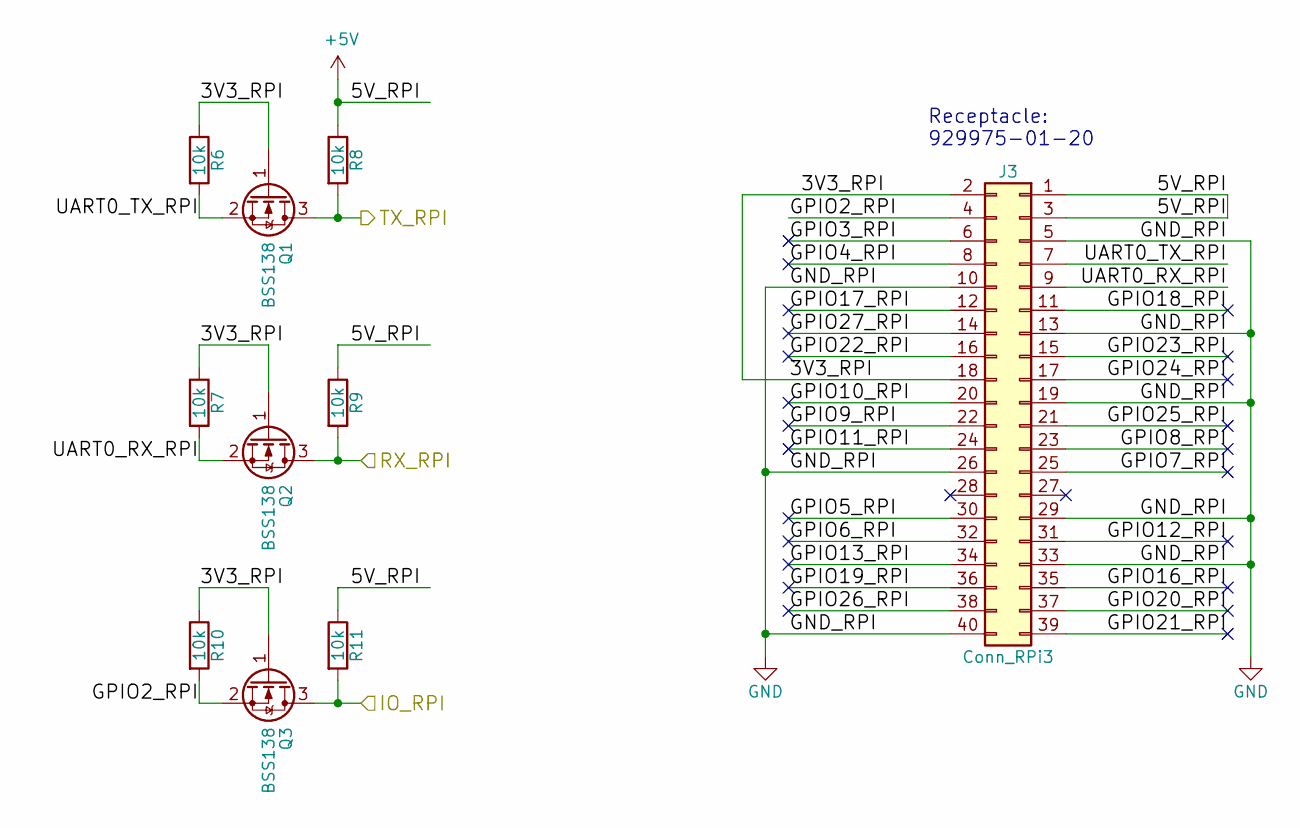
[picture p3: schematic RaspberryPi3Conn.sch]

Parts:
J3: Conn_RPi3; PinHeader_2x20_P2.54mm_Vertical
Q1, Q2, Q3: BSS138; SOT-23
R6, R7, R8, R9, R10, R11: 10k; R_0603_1608Metric

Connections:
+5V: J3.1, J3.3, R8.1, R9.1, R11.1; also elsewhere on the board
/MCU/RX0_MCU: Q1.3 (D), R8.2; also elsewhere on the board
/RaspberryPi3Conn/3V3_RPI: J3.2, J3.18, Q1.1 (G), Q2.1 (G), Q3.1 (G), R6.1, R7.1, R10.1
/RaspberryPi3Conn/GPIO2_RPI: J3.4, Q3.2 (S), R10.2
/RaspberryPi3Conn/GPIO3_RPI: J3.6
/RaspberryPi3Conn/GPIO4_RPI: J3.8
/RaspberryPi3Conn/GPIO5_RPI: J3.30
/RaspberryPi3Conn/GPIO6_RPI: J3.32
/RaspberryPi3Conn/GPIO7_RPI: J3.25
/RaspberryPi3Conn/GPIO8_RPI: J3.23
/RaspberryPi3Conn/GPIO9_RPI: J3.22
/RaspberryPi3Conn/GPIO10_RPI: J3.20
/RaspberryPi3Conn/GPIO11_RPI: J3.24
/RaspberryPi3Conn/GPIO12_RPI: J3.31
/RaspberryPi3Conn/GPIO13_RPI: J3.34
/RaspberryPi3Conn/GPIO16_RPI: J3.35
/RaspberryPi3Conn/GPIO17_RPI: J3.12
/RaspberryPi3Conn/GPIO18_RPI: J3.11
/RaspberryPi3Conn/GPIO19_RPI: J3.36
/RaspberryPi3Conn/GPIO20_RPI: J3.37
/RaspberryPi3Conn/GPIO21_RPI: J3.39
/RaspberryPi3Conn/GPIO22_RPI: J3.16
/RaspberryPi3Conn/GPIO23_RPI: J3.15
/RaspberryPi3Conn/GPIO24_RPI: J3.17
/RaspberryPi3Conn/GPIO25_RPI: J3.21
/RaspberryPi3Conn/GPIO26_RPI: J3.38
/RaspberryPi3Conn/GPIO27_RPI: J3.14
/RaspberryPi3Conn/RX_RPI: Q2.3 (D), R9.2; also elsewhere on the board
/RaspberryPi3Conn/UART0_RX_RPI: J3.9, Q2.2 (S), R7.2
/RaspberryPi3Conn/UART0_TX_RPI: J3.7, Q1.2 (S), R6.2
GND: J3.5, J3.10, J3.13, J3.19, J3.26, J3.29, J3.33, J3.40; also elsewhere on the board
IO0: Q3.3 (D), R11.2; also elsewhere on the board

Notes on the sheet:
Receptacle: 929975-01-20

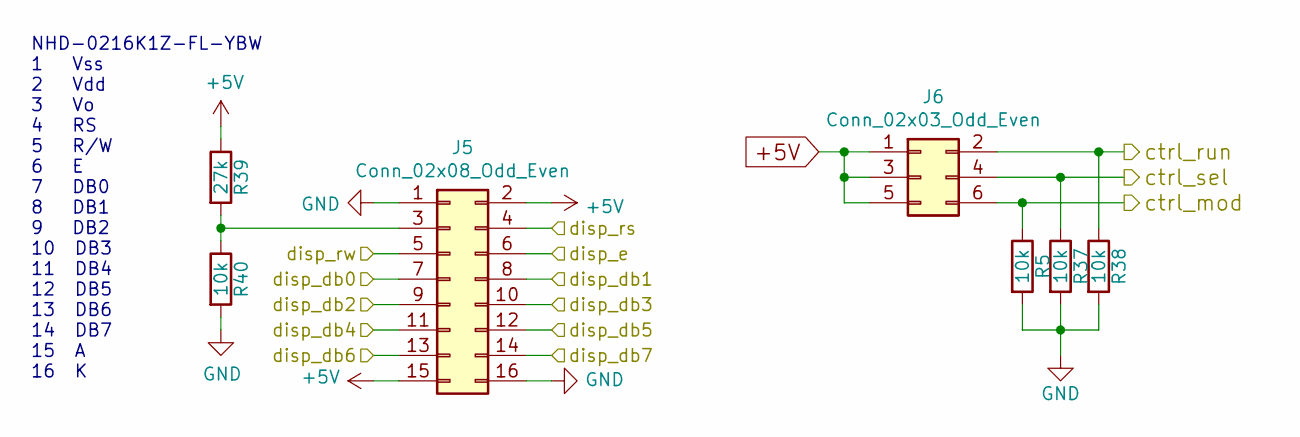
[picture p4: schematic testController.sch]

Parts:
J5: Conn_02x08_Odd_Even; PinHeader_2x08_P2.54mm_Vertical
J6: Conn_02x03_Odd_Even; PinHeader_2x03_P2.54mm_Vertical
R5, R37, R38, R40: 10k; R_0603_1608Metric
R39: 27k; R_0603_1608Metric

Connections:
+5V: J5.2, J5.15, J6.1, J6.3, J6.5, R39.1; also elsewhere on the board
/MCU/ctrl_mod: J6.6, R5.1; also elsewhere on the board
/MCU/ctrl_run: J6.2, R38.1; also elsewhere on the board
/MCU/ctrl_sel: J6.4, R37.1; also elsewhere on the board
/MCU/disp_db0: J5.7; also elsewhere on the board
/MCU/disp_db1: J5.8; also elsewhere on the board
/MCU/disp_db2: J5.9; also elsewhere on the board
/MCU/disp_db3: J5.10; also elsewhere on the board
/MCU/disp_db4: J5.11; also elsewhere on the board
/MCU/disp_db5: J5.12; also elsewhere on the board
/MCU/disp_db6: J5.13; also elsewhere on the board
/MCU/disp_db7: J5.14; also elsewhere on the board
/MCU/disp_e: J5.6; also elsewhere on the board
/MCU/disp_rs: J5.4; also elsewhere on the board
/MCU/disp_rw: J5.5; also elsewhere on the board
GND: J5.1, J5.16, R5.2, R37.2, R38.2, R40.2; also elsewhere on the board
unnamed: J5.3, R39.2, R40.1

Notes on the sheet:
NHD-0216K1Z-FL-YBW 1 Vss 2 Vdd 3 Vo 4 RS 5 R/W 6 E 7 DB0 8 DB1 9 DB2 10 DB3 11 DB4 12 DB5 13 DB6 14 DB7 15 A 16 K

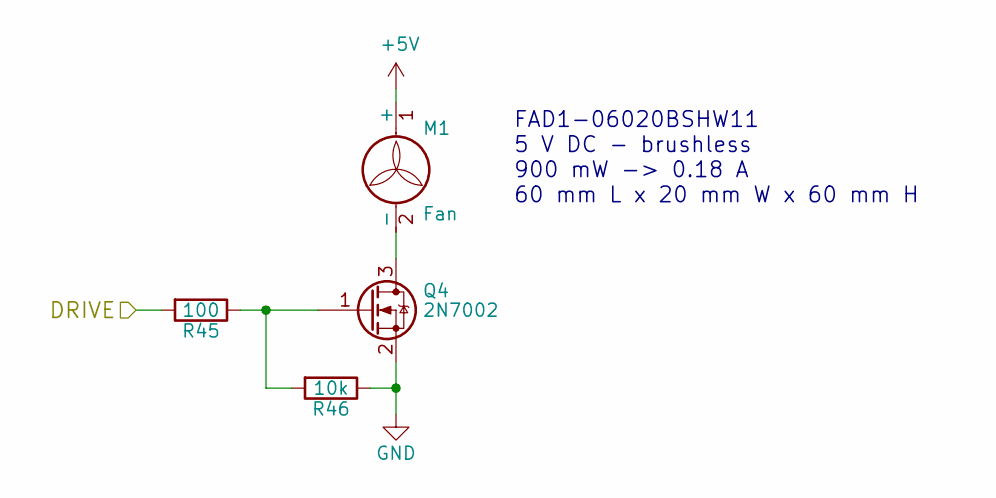
[picture p5: schematic fanDriver.sch]

Parts:
M1: Fan; PinHeader_1x02_P2.54mm_Vertical
Q4: 2N7002; SOT-23
R45: 100; R_0603_1608Metric
R46: 10k; R_0603_1608Metric

Connections:
+5V: M1.1 (+); also elsewhere on the board
/fanDriver/DRIVE: R45.2; also elsewhere on the board
GND: Q4.2 (S), R46.1; also elsewhere on the board
unnamed: M1.2 (-), Q4.3 (D)
unnamed: Q4.1 (G), R45.1, R46.2

Notes on the sheet:
FAD1-06020BSHW11 5 V DC - brushless 900 mW -> 0.18 A 60 mm L x 20 mm W x 60 mm H

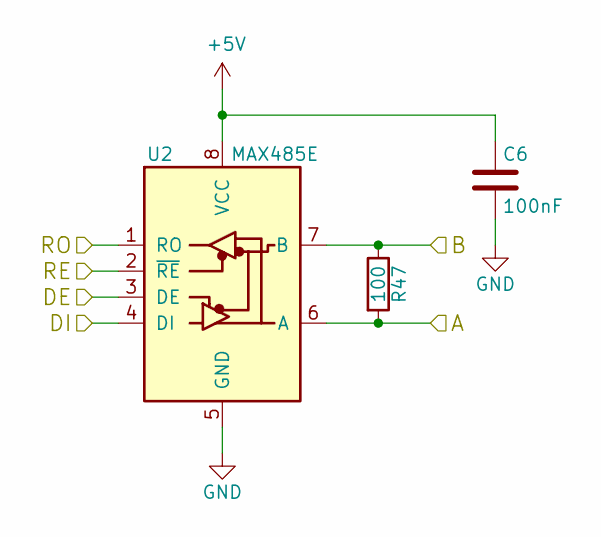
[picture p6: schematic RS485.sch]

Parts:
C6: 100nF; C_0603_1608Metric
R47: 100; R_0603_1608Metric
U2: MAX485E; SOIC-8_3.9x4.9mm_P1.27mm

Connections:
+5V: C6.1, U2.8 (VCC); also elsewhere on the board
/RS485/DE: U2.2 (~RE), U2.3 (DE); also elsewhere on the board
/RS485/DI: U2.4 (DI); also elsewhere on the board
/RS485/RO: U2.1 (RO); also elsewhere on the board
GND: C6.2, U2.5 (GND); also elsewhere on the board
RS_485-A: R47.2, U2.6 (A); also elsewhere on the board
RS_485-B: R47.1, U2.7 (B); also elsewhere on the board

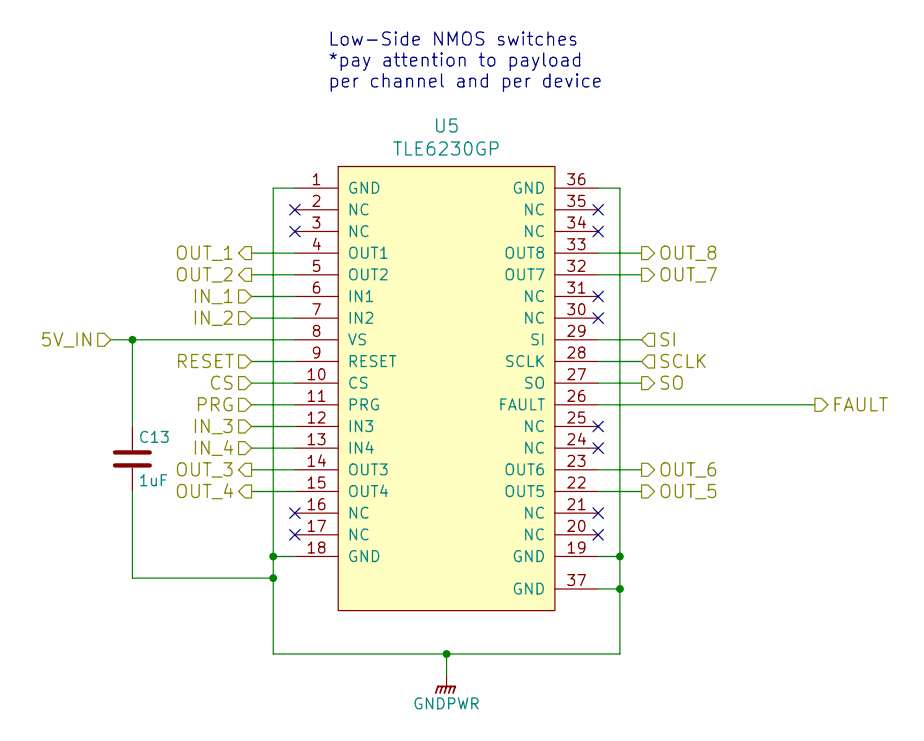
[picture p7: schematic lowSideDriver.sch]

Parts:
C1: 1uF; C_0603_1608Metric
U3: TLE6230GP; PG-DSO-36

Connections:
+5V: C1.1, U3.8 (VS); also elsewhere on the board
/MCU/DRV_FLT: U3.26 (FAULT); also elsewhere on the board
/MCU/DRV_RESET: U3.9 (RESET); also elsewhere on the board
/MCU/MISO: U3.27 (SO); also elsewhere on the board
/MCU/MOSI: U3.29 (SI); also elsewhere on the board
/MCU/SCK: U3.28 (SCLK); also elsewhere on the board
/lowSideDriver1/CS: U3.10 (CS); also elsewhere on the board
/lowSideDriver1/IN_1: U3.6 (IN1)
/lowSideDriver1/IN_2: U3.7 (IN2)
/lowSideDriver1/IN_3: U3.12 (IN3)
/lowSideDriver1/IN_4: U3.13 (IN4)
/lowSideDriver1/PRG: U3.11 (PRG)
GNDPWR: C1.2, U3.1 (GND), U3.18 (GND), U3.19 (GND), U3.36 (GND), U3.37 (GND); also elsewhere on the board
PUMP_LOW_SIDE: U3.22 (OUT5); also elsewhere on the board
VALVE_1_LOW_SIDE: U3.23 (OUT6); also elsewhere on the board
VALVE_2_LOW_SIDE: U3.33 (OUT8); also elsewhere on the board
VALVE_3_LOW_SIDE: U3.32 (OUT7); also elsewhere on the board
VALVE_4_LOW_SIDE: U3.5 (OUT2); also elsewhere on the board
VALVE_5_LOW_SIDE: U3.4 (OUT1); also elsewhere on the board
VALVE_6_LOW_SIDE: U3.15 (OUT4); also elsewhere on the board
VALVE_7_LOW_SIDE: U3.14 (OUT3); also elsewhere on the board

Parts of its further copies:
C12, C13: 1uF; C_0603_1608Metric
U4, U5: TLE6230GP; PG-DSO-36

Connections of its further copies:
+5V: C12.1, C13.1, U4.8 (VS), U5.8 (VS); also elsewhere on the board
/MCU/DRV_FLT: U4.26 (FAULT), U5.26 (FAULT); also elsewhere on the board
/MCU/DRV_RESET: U4.9 (RESET), U5.9 (RESET); also elsewhere on the board
/MCU/MISO: U4.27 (SO), U5.27 (SO); also elsewhere on the board
/MCU/MOSI: U4.29 (SI), U5.29 (SI); also elsewhere on the board
/MCU/SCK: U4.28 (SCLK), U5.28 (SCLK); also elsewhere on the board
/lowSideDriver2/CS: U4.10 (CS); also elsewhere on the board
/lowSideDriver2/IN_1: U4.6 (IN1)
/lowSideDriver2/IN_2: U4.7 (IN2)
/lowSideDriver2/IN_3: U4.12 (IN3)
/lowSideDriver2/IN_4: U4.13 (IN4)
/lowSideDriver2/PRG: U4.11 (PRG)
/lowSideDriver3/CS: U5.10 (CS); also elsewhere on the board
/lowSideDriver3/IN_1: U5.6 (IN1)
/lowSideDriver3/IN_2: U5.7 (IN2)
/lowSideDriver3/IN_3: U5.12 (IN3)
/lowSideDriver3/IN_4: U5.13 (IN4)
/lowSideDriver3/PRG: U5.11 (PRG)
GNDPWR: C12.2, C13.2, U4.1 (GND), U4.18 (GND), U4.19 (GND), U4.36 (GND), U4.37 (GND), U5.1 (GND), U5.18 (GND), U5.19 (GND), U5.36 (GND), U5.37 (GND); also elsewhere on the board
MISC_LOW_SIDE_1: U4.4 (OUT1); also elsewhere on the board
MISC_LOW_SIDE_2: U4.14 (OUT3); also elsewhere on the board
MISC_LOW_SIDE_3: U4.15 (OUT4); also elsewhere on the board
MISC_LOW_SIDE_4: U5.22 (OUT5); also elsewhere on the board
MISC_LOW_SIDE_5: U5.23 (OUT6); also elsewhere on the board
MISC_LOW_SIDE_6: U5.32 (OUT7); also elsewhere on the board
MISC_LOW_SIDE_7: U5.33 (OUT8); also elsewhere on the board
MISC_LOW_SIDE_8: U5.4 (OUT1); also elsewhere on the board
MISC_LOW_SIDE_9: U5.5 (OUT2); also elsewhere on the board
MISC_LOW_SIDE_10: U5.14 (OUT3); also elsewhere on the board
MISC_LOW_SIDE_11: U5.15 (OUT4); also elsewhere on the board
VALVE_8_LOW_SIDE: U4.23 (OUT6); also elsewhere on the board
VALVE_9_LOW_SIDE: U4.22 (OUT5); also elsewhere on the board
VALVE_10_LOW_SIDE: U4.33 (OUT8); also elsewhere on the board
VALVE_11_LOW_SIDE: U4.32 (OUT7); also elsewhere on the board
VALVE_12_LOW_SIDE: U4.5 (OUT2); also elsewhere on the board

Notes on the sheet:
Low-Side NMOS switches *pay attention to payload per channel and per device

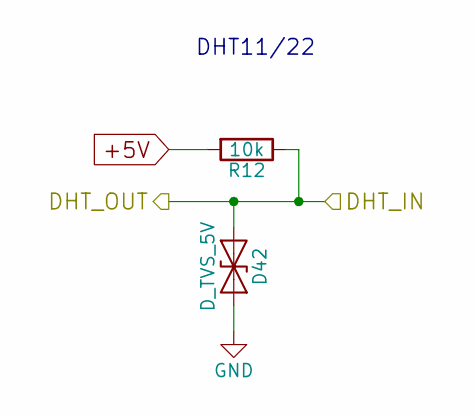
[picture p8: schematic tempHumSens.sch]

Parts:
D42: D_TVS_5V; D_SMA
R12: 10k; R_0603_1608Metric

Connections:
+5V: R12.2; also elsewhere on the board
/DHT_SIG: D42.1 (A1), R12.1; also elsewhere on the board
GND: D42.2 (A2); also elsewhere on the board

Notes on the sheet:
DHT11/22

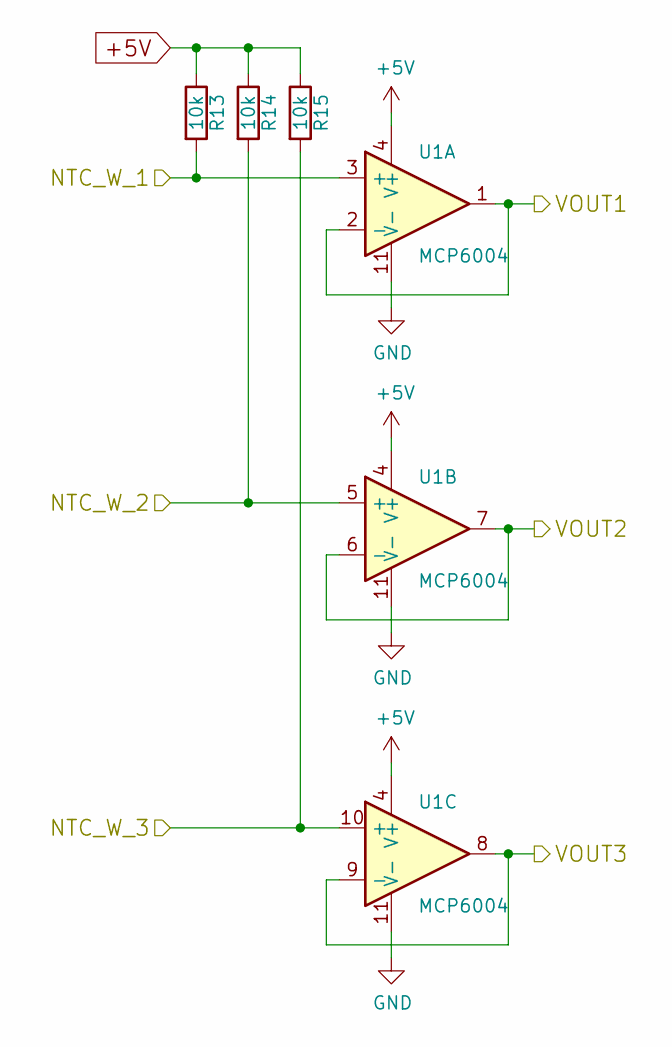
[picture p9: schematic WaterNTCs.sch]

Parts:
R13, R14, R15: 10k; R_0603_1608Metric
U1: MCP6004; SOIC-14_3.9x8.7mm_P1.27mm

Connections:
+5V: R13.1, R14.1, R15.1, U1.4 (V+); also elsewhere on the board
/MCU/ADC3: U1.1, U1.2 (-); also elsewhere on the board
/MCU/ADC4: U1.6 (-), U1.7; also elsewhere on the board
/MCU/ADC5: U1.8, U1.9 (-); also elsewhere on the board
/NTC_W1: R13.2, U1.3 (+); also elsewhere on the board
/NTC_W2: R14.2, U1.5 (+); also elsewhere on the board
/NTC_W3: R15.2, U1.10 (+); also elsewhere on the board
GND: U1.11 (V-); also elsewhere on the board

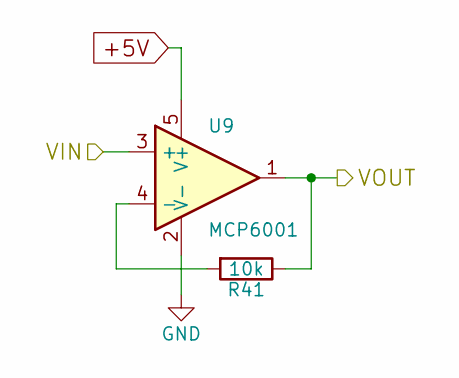
[picture p10: schematic pressureSensor.sch]

Parts:
R41: 10k; R_0603_1608Metric
U9: MCP6001; SOT-23-5

Connections:
+5V: U9.5 (V+); also elsewhere on the board
/MCU/ADC6: R41.1, U9.1; also elsewhere on the board
/WPS_SIG: U9.3 (+); also elsewhere on the board
GND: U9.2 (V-); also elsewhere on the board
unnamed: R41.2, U9.4 (-)

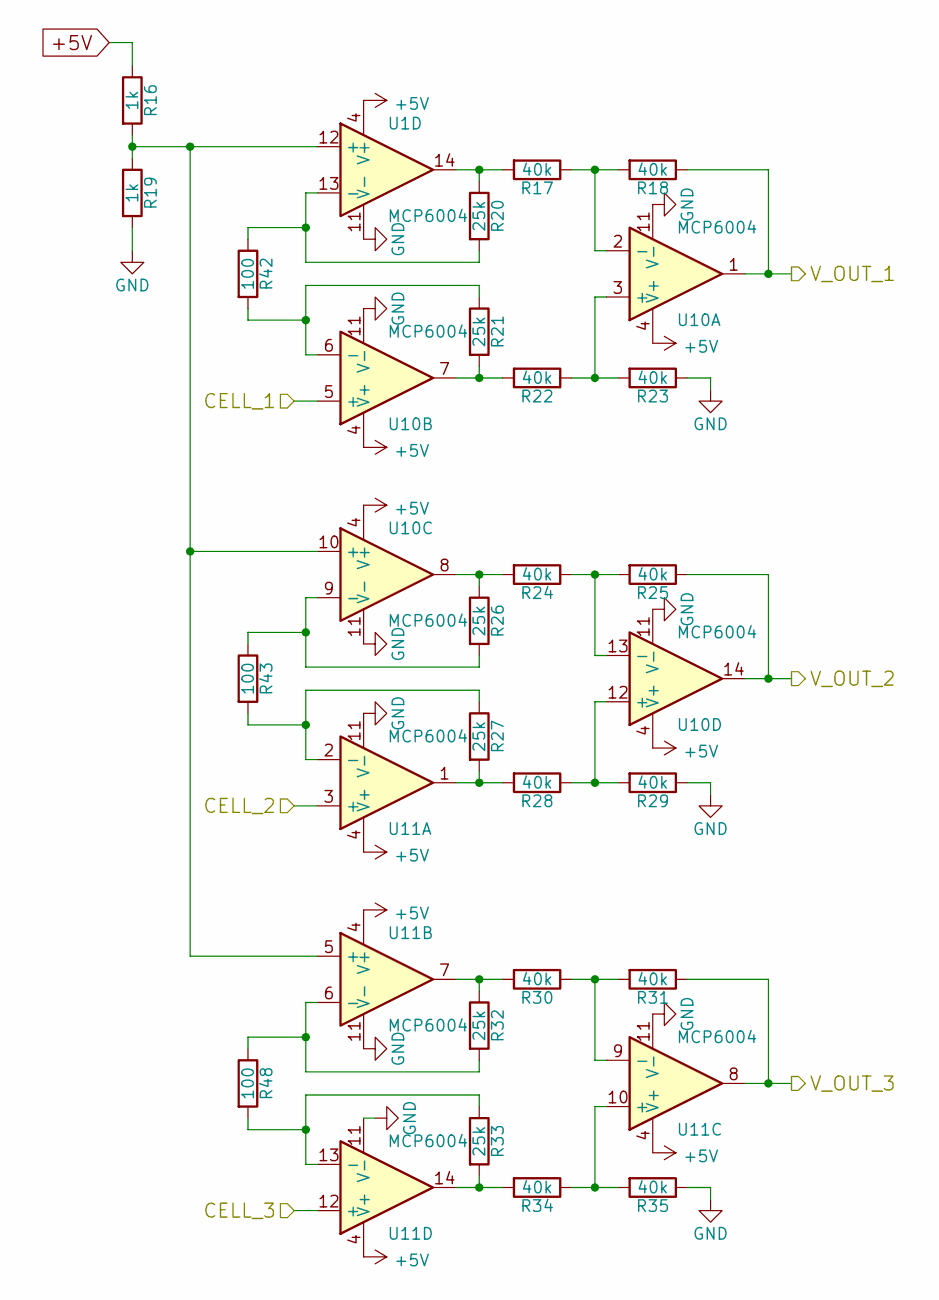
[picture p11: schematic loadCells.sch]

Parts:
R16, R19: 1k; R_0603_1608Metric
R17, R18, R22, R23, R24, R25, R28, R29, R30, R31, R34, R35: 40k; R_0603_1608Metric
R20, R21, R26, R27, R32, R33: 25k; R_0603_1608Metric
R42, R43, R48: 100; R_0603_1608Metric
U1, U10, U11: MCP6004; SOIC-14_3.9x8.7mm_P1.27mm

Connections:
+5V: R16.1, U1.4 (V+), U10.4 (V+), U11.4 (V+); also elsewhere on the board
/LC_1: U10.5 (+); also elsewhere on the board
/LC_2: U11.3 (+); also elsewhere on the board
/LC_3: U11.12 (+); also elsewhere on the board
/MCU/ADC7: R18.1, U10.1; also elsewhere on the board
/MCU/ADC8: R25.1, U10.14; also elsewhere on the board
/MCU/ADC9: R31.1, U11.8; also elsewhere on the board
GND: R19.2, R23.1, R29.1, R35.1, U1.11 (V-), U10.11 (V-), U11.11 (V-); also elsewhere on the board
unnamed: R16.2, R19.1, U1.12 (+), U10.10 (+), U11.5 (+)
unnamed: R17.1, R18.2, U10.2 (-)
unnamed: R17.2, R20.1, U1.14
unnamed: R20.2, R42.1, U1.13 (-)
unnamed: R21.1, R42.2, U10.6 (-)
unnamed: R21.2, R22.2, U10.7
unnamed: R22.1, R23.2, U10.3 (+)
unnamed: R24.1, R25.2, U10.13 (-)
unnamed: R24.2, R26.1, U10.8
unnamed: R26.2, R43.1, U10.9 (-)
unnamed: R27.1, R43.2, U11.2 (-)
unnamed: R27.2, R28.2, U11.1
unnamed: R28.1, R29.2, U10.12 (+)
unnamed: R30.1, R31.2, U11.9 (-)
unnamed: R30.2, R32.1, U11.7
unnamed: R32.2, R48.1, U11.6 (-)
unnamed: R33.1, R48.2, U11.13 (-)
unnamed: R33.2, R34.2, U11.14
unnamed: R34.1, R35.2, U11.10 (+)

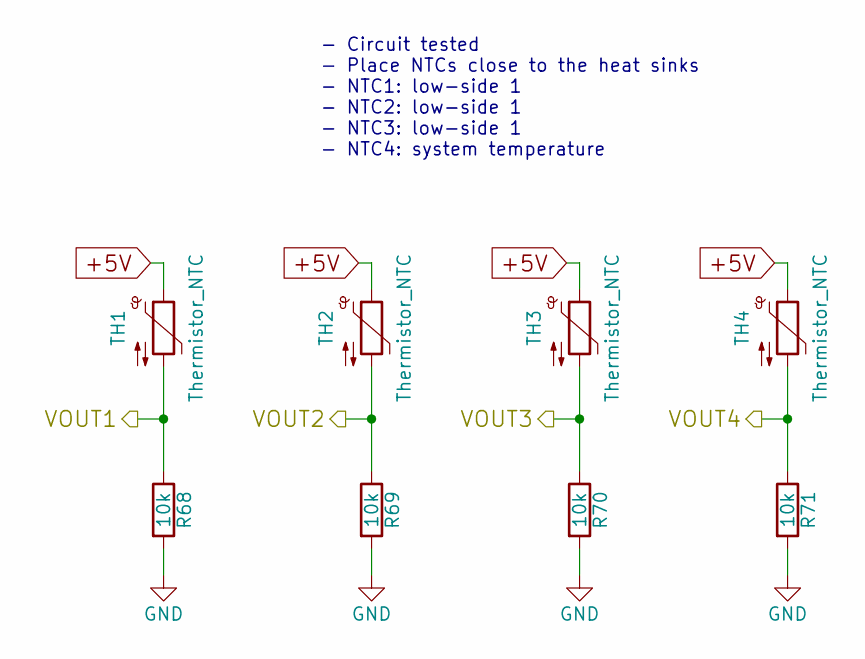
[picture p12: schematic NTC.sch]

Parts:
R68, R69, R70, R71: 10k; R_0603_1608Metric
TH1, TH2, TH3, TH4: Thermistor_NTC; R_0603_1608Metric

Connections:
+5V: TH1.1, TH2.1, TH3.1, TH4.1; also elsewhere on the board
/MCU/ADC10: R68.1, TH1.2; also elsewhere on the board
/MCU/ADC11: R69.1, TH2.2; also elsewhere on the board
/MCU/ADC12: R70.1, TH3.2; also elsewhere on the board
/MCU/ADC13: R71.1, TH4.2; also elsewhere on the board
GND: R68.2, R69.2, R70.2, R71.2; also elsewhere on the board

Notes on the sheet:
- Circuit tested - Place NTCs close to the heat sinks - NTC1: low-side 1 - NTC2: low-side 1 - NTC3: low-side 1 - NTC4: system temperature

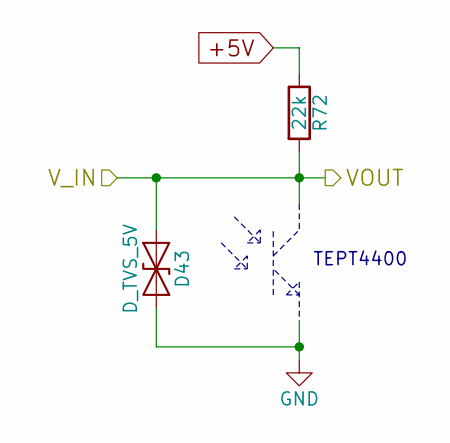
[picture p13: schematic lightSensor.sch]

Parts:
D43: D_TVS_5V; D_SMA
R72: 22k; R_0603_1608Metric

Connections:
+5V: R72.1; also elsewhere on the board
/LS_SIG: D43.1 (A1), R72.2; also elsewhere on the board
GND: D43.2 (A2); also elsewhere on the board

Notes on the sheet:
TEPT4400

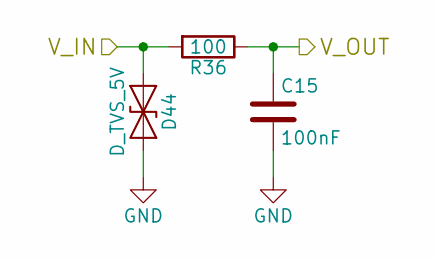
[picture p14: schematic CO2Sensor.sch]

Parts:
C15: 100nF; C_0603_1608Metric
D44: D_TVS_5V; D_SMA
R36: 100; R_0603_1608Metric

Connections:
/CO2_SIG: D44.1 (A1), R36.2; also elsewhere on the board
/MCU/ADC15: C15.1, R36.1; also elsewhere on the board
GND: C15.2, D44.2 (A2); also elsewhere on the board

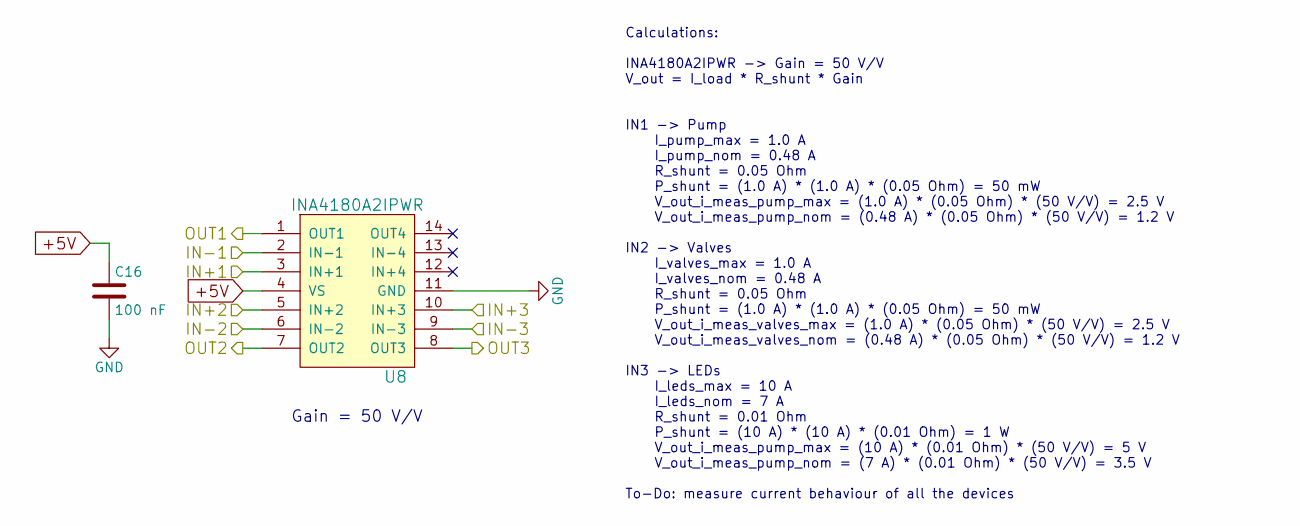
[picture p15: schematic currentSensor.sch]

Parts:
C16: 100 nF; C_0603_1608Metric
U8: INA4180A2IPWR; TSSOP-14_4.4x5mm_P0.65mm

Connections:
+5V: C16.1, U8.4 (VS); also elsewhere on the board
+24V_LEDS: U8.9 (IN-3); also elsewhere on the board
+24V_PUMP: U8.2 (IN-1); also elsewhere on the board
+24V_VALVES: U8.6 (IN-2); also elsewhere on the board
/IN+1: U8.3 (IN+1); also elsewhere on the board
/IN+2: U8.5 (IN+2); also elsewhere on the board
/IN+3: U8.10 (IN+3); also elsewhere on the board
/MCU/ADC0: U8.1 (OUT1); also elsewhere on the board
/MCU/ADC1: U8.7 (OUT2); also elsewhere on the board
/MCU/ADC2: U8.8 (OUT3); also elsewhere on the board
GND: C16.2, U8.11 (GND); also elsewhere on the board

Notes on the sheet:
Gain = 50 V/V
Calculations: INA4180A2IPWR -> Gain = 50 V/V V_out = I_load * R_shunt * Gain IN1 -> Pump I_pump_max = 1.0 A I_pump_nom = 0.48 A R_shunt = 0.05 Ohm P_shunt = (1.0 A) * (1.0 A) * (0.05 Ohm) = 50 mW V_out_i_meas_pump_max = (1.0 A) * (0.05 Ohm) * (50 V/V) = 2.5 V V_out_i_meas_pump_nom = (0.48 A) * (0.0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
