Montufar/Hexagro_MBV2.1/motherBoard_V2.1.kicad_pcb

## KiCad design motherBoard_V2.1.kicad_pcb (continued)

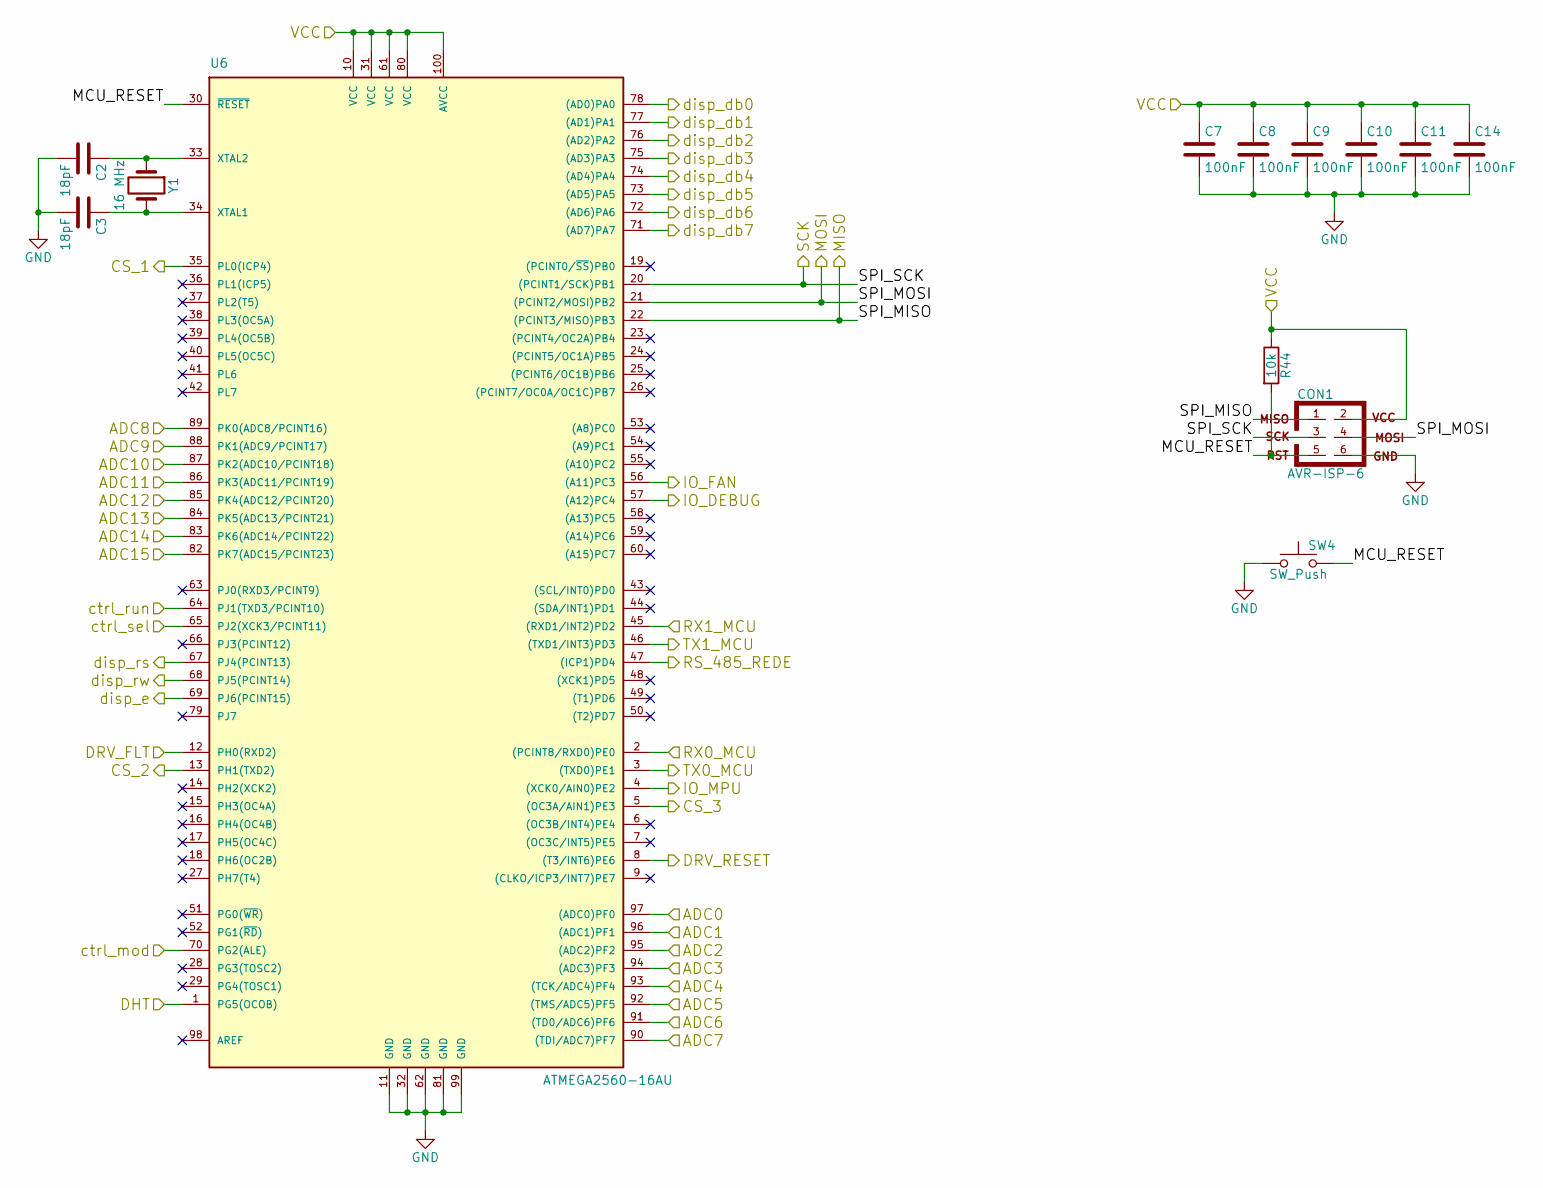
[picture p16: schematic MCU.sch]

Parts:
C2, C3: 18pF; C_0603_1608Metric
C7, C8, C9, C10, C11, C14: 100nF; C_0603_1608Metric
CON1: AVR-ISP-6; PinHeader_2x03_P2.54mm_Vertical
R44: 10k; R_0603_1608Metric
SW4: SW_Push; SW_Push_1P1T_NO_CK_KSC6xxJ
U6: ATMEGA2560-16AU; TQFP-100_14x14mm_P0.5mm
Y1: 16 MHz; Crystal_SMD_0603-2Pin_6.0x3.5mm

Connections:
+5V: C7.1, C8.1, C9.1, C10.1, C11.1, C14.1, CON1.2, R44.1, U6.10 (VCC), U6.31 (VCC), U6.61 (VCC), U6.80 (VCC), U6.100 (AVCC); also elsewhere on the board
/DHT_SIG: U6.1 (PG5(OCOB)); also elsewhere on the board
/LS_SIG: U6.83 (PK6(ADC14/PCINT22)); also elsewhere on the board
/MCU/ADC0: U6.97 ((ADC0)PF0); also elsewhere on the board
/MCU/ADC1: U6.96 ((ADC1)PF1); also elsewhere on the board
/MCU/ADC2: U6.95 ((ADC2)PF2); also elsewhere on the board
/MCU/ADC3: U6.94 ((ADC3)PF3); also elsewhere on the board
/MCU/ADC4: U6.93 ((TCK/ADC4)PF4); also elsewhere on the board
/MCU/ADC5: U6.92 ((TMS/ADC5)PF5); also elsewhere on the board
/MCU/ADC6: U6.91 ((TD0/ADC6)PF6); also elsewhere on the board
/MCU/ADC7: U6.90 ((TDI/ADC7)PF7); also elsewhere on the board
/MCU/ADC8: U6.89 (PK0(ADC8/PCINT16)); also elsewhere on the board
/MCU/ADC9: U6.88 (PK1(ADC9/PCINT17)); also elsewhere on the board
/MCU/ADC10: U6.87 (PK2(ADC10/PCINT18)); also elsewhere on the board
/MCU/ADC11: U6.86 (PK3(ADC11/PCINT19)); also elsewhere on the board
/MCU/ADC12: U6.85 (PK4(ADC12/PCINT20)); also elsewhere on the board
/MCU/ADC13: U6.84 (PK5(ADC13/PCINT21)); also elsewhere on the board
/MCU/ADC15: U6.82 (PK7(ADC15/PCINT23)); also elsewhere on the board
/MCU/DRV_FLT: U6.12 (PH0(RXD2)); also elsewhere on the board
/MCU/DRV_RESET: U6.8 ((T3/INT6)PE6); also elsewhere on the board
/MCU/MCU_RESET: CON1.5, R44.2, SW4.2, U6.30 (~RESET)
/MCU/MISO: CON1.1, U6.22 ((PCINT3/MISO)PB3); also elsewhere on the board
/MCU/MOSI: CON1.4, U6.21 ((PCINT2/MOSI)PB2); also elsewhere on the board
/MCU/RX0_MCU: U6.2 ((PCINT8/RXD0)PE0); also elsewhere on the board
/MCU/SCK: CON1.3, U6.20 ((PCINT1/SCK)PB1); also elsewhere on the board
/MCU/ctrl_mod: U6.70 (PG2(ALE)); also elsewhere on the board
/MCU/ctrl_run: U6.64 (PJ1(TXD3/PCINT10)); also elsewhere on the board
/MCU/ctrl_sel: U6.65 (PJ2(XCK3/PCINT11)); also elsewhere on the board
/MCU/disp_db0: U6.78 ((AD0)PA0); also elsewhere on the board
/MCU/disp_db1: U6.77 ((AD1)PA1); also elsewhere on the board
/MCU/disp_db2: U6.76 ((AD2)PA2); also elsewhere on the board
/MCU/disp_db3: U6.75 ((AD3)PA3); also elsewhere on the board
/MCU/disp_db4: U6.74 ((AD4)PA4); also elsewhere on the board
/MCU/disp_db5: U6.73 ((AD5)PA5); also elsewhere on the board
/MCU/disp_db6: U6.72 ((AD6)PA6); also elsewhere on the board
/MCU/disp_db7: U6.71 ((AD7)PA7); also elsewhere on the board
/MCU/disp_e: U6.69 (PJ6(PCINT15)); also elsewhere on the board
/MCU/disp_rs: U6.67 (PJ4(PCINT13)); also elsewhere on the board
/MCU/disp_rw: U6.68 (PJ5(PCINT14)); also elsewhere on the board
/RS485/DE: U6.47 ((ICP1)PD4); also elsewhere on the board
/RS485/DI: U6.46 ((TXD1/INT3)PD3); also elsewhere on the board
/RS485/RO: U6.45 ((RXD1/INT2)PD2); also elsewhere on the board
/RaspberryPi3Conn/RX_RPI: U6.3 ((TXD0)PE1); also elsewhere on the board
/fanDriver/DRIVE: U6.56 ((A11)PC3); also elsewhere on the board
/lowSideDriver1/CS: U6.35 (PL0(ICP4)); also elsewhere on the board
/lowSideDriver2/CS: U6.13 (PH1(TXD2)); also elsewhere on the board
/lowSideDriver3/CS: U6.5 ((OC3A/AIN1)PE3); also elsewhere on the board
GND: C2.2, C3.2, C7.2, C8.2, C9.2, C10.2, C11.2, C14.2, CON1.6, SW4.1, U6.11 (GND), U6.32 (GND), U6.62 (GND), U6.81 (GND), U6.99 (GND); also elsewhere on the board
IO0: U6.4 ((XCK0/AIN0)PE2); also elsewhere on the board
MCU_DEBUG: U6.57 ((A12)PC4); also elsewhere on the board
unnamed: C2.1, U6.33 (XTAL2), Y1.1
unnamed: C3.1, U6.34 (XTAL1), Y1.2

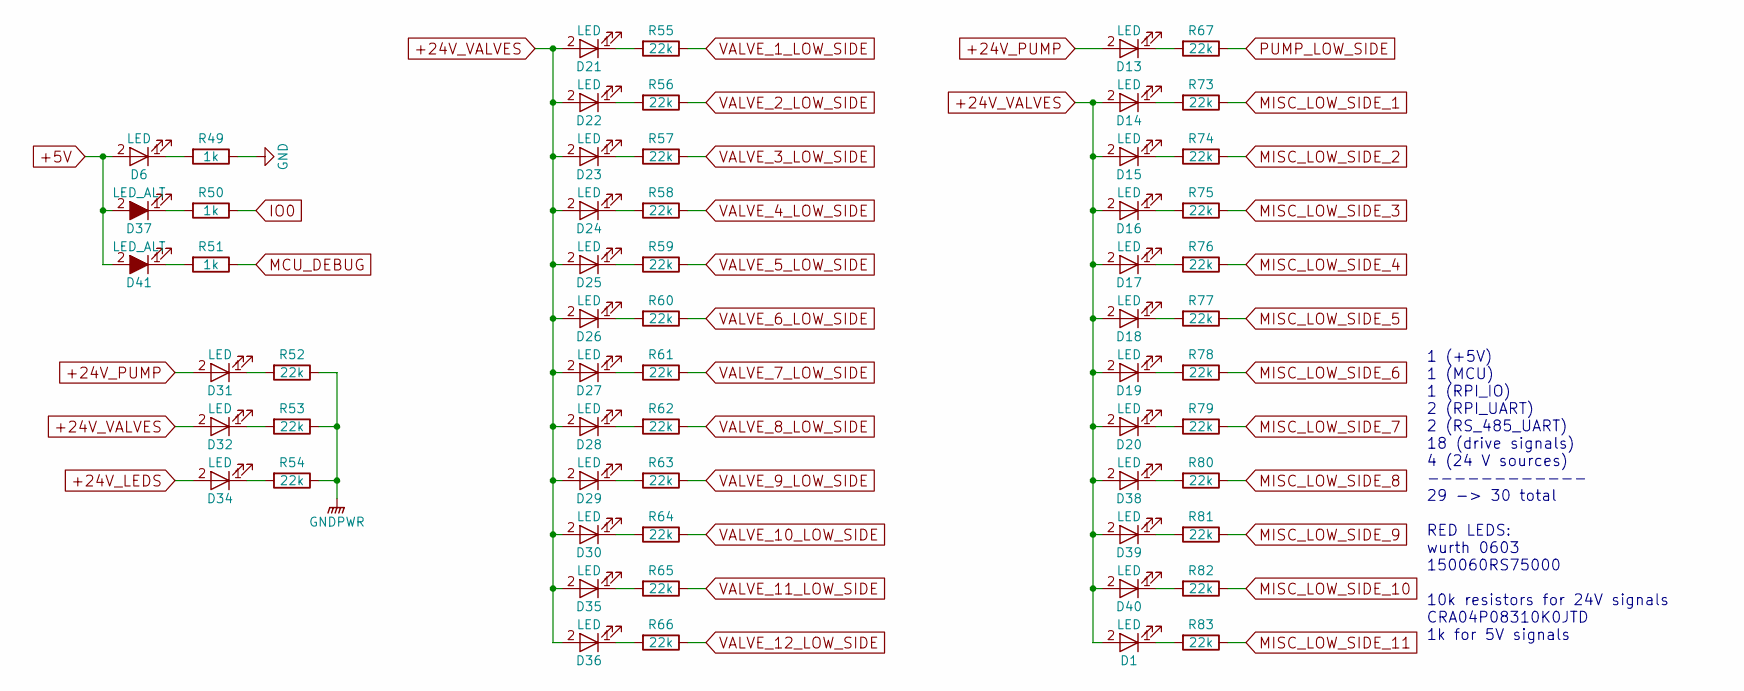
[picture p17: schematic indicatorLEDs.sch]

Parts:
D1, D6, D13, D14, D15, D16, D17, D18, D19, D20, D21, D22, D23, D24, D25, D26, D27, D28, D29, D30, D31, D32, D34, D35, D36, D38, D39, D40: LED; LED_0603_1608Metric
D37, D41: LED_ALT; LED_D5.0mm
R49, R50, R51: 1k; R_0603_1608Metric
R52, R53, R54, R55, R56, R57, R58, R59, R60, R61, R62, R63, R64, R65, R66, R67, R73, R74, R75, R76, R77, R78, R79, R80, R81, R82, R83: 22k; R_0603_1608Metric

Connections:
+5V: D6.2 (A), D37.2 (A), D41.2 (A); also elsewhere on the board
+24V_LEDS: D34.2 (A); also elsewhere on the board
+24V_PUMP: D13.2 (A), D31.2 (A); also elsewhere on the board
+24V_VALVES: D1.2 (A), D14.2 (A), D15.2 (A), D16.2 (A), D17.2 (A), D18.2 (A), D19.2 (A), D20.2 (A), D21.2 (A), D22.2 (A), D23.2 (A), D24.2 (A), D25.2 (A), D26.2 (A), D27.2 (A), D28.2 (A), D29.2 (A), D30.2 (A), D32.2 (A), D35.2 (A), D36.2 (A), D38.2 (A), D39.2 (A), D40.2 (A); also elsewhere on the board
GND: R49.1; also elsewhere on the board
GNDPWR: R52.1, R53.1, R54.1; also elsewhere on the board
IO0: R50.1; also elsewhere on the board
MCU_DEBUG: R51.1; also elsewhere on the board
MISC_LOW_SIDE_1: R73.1; also elsewhere on the board
MISC_LOW_SIDE_2: R74.1; also elsewhere on the board
MISC_LOW_SIDE_3: R75.1; also elsewhere on the board
MISC_LOW_SIDE_4: R76.1; also elsewhere on the board
MISC_LOW_SIDE_5: R77.1; also elsewhere on the board
MISC_LOW_SIDE_6: R78.1; also elsewhere on the board
MISC_LOW_SIDE_7: R79.1; also elsewhere on the board
MISC_LOW_SIDE_8: R80.1; also elsewhere on the board
MISC_LOW_SIDE_9: R81.1; also elsewhere on the board
MISC_LOW_SIDE_10: R82.1; also elsewhere on the board
MISC_LOW_SIDE_11: R83.1; also elsewhere on the board
unnamed: D1.1 (K), R83.2
unnamed: D6.1 (K), R49.2
unnamed: D13.1 (K), R67.2
unnamed: D14.1 (K), R73.2
unnamed: D15.1 (K), R74.2
unnamed: D16.1 (K), R75.2
unnamed: D17.1 (K), R76.2
unnamed: D18.1 (K), R77.2
unnamed: D19.1 (K), R78.2
unnamed: D20.1 (K), R79.2
unnamed: D21.1 (K), R55.2
unnamed: D22.1 (K), R56.2
unnamed: D23.1 (K), R57.2
unnamed: D24.1 (K), R58.2
unnamed: D25.1 (K), R59.2
unnamed: D26.1 (K), R60.2
unnamed: D27.1 (K), R61.2
unnamed: D28.1 (K), R62.2
unnamed: D29.1 (K), R63.2
unnamed: D30.1 (K), R64.2
unnamed: D31.1 (K), R52.2
unnamed: D32.1 (K), R53.2
unnamed: D34.1 (K), R54.2
unnamed: D35.1 (K), R65.2
unnamed: D36.1 (K), R66.2
unnamed: D37.1 (K), R50.2
unnamed: D38.1 (K), R80.2
unnamed: D39.1 (K), R81.2
unnamed: D40.1 (K), R82.2
unnamed: D41.1 (K), R51.2
PUMP_LOW_SIDE: R67.1; also elsewhere on the board
VALVE_1_LOW_SIDE: R55.1; also elsewhere on the board
VALVE_2_LOW_SIDE: R56.1; also elsewhere on the board
VALVE_3_LOW_SIDE: R57.1; also elsewhere on the board
VALVE_4_LOW_SIDE: R58.1; also elsewhere on the board
VALVE_5_LOW_SIDE: R59.1; also elsewhere on the board
VALVE_6_LOW_SIDE: R60.1; also elsewhere on the board
VALVE_7_LOW_SIDE: R61.1; also elsewhere on the board
VALVE_8_LOW_SIDE: R62.1; also elsewhere on the board
VALVE_9_LOW_SIDE: R63.1; also elsewhere on the board
VALVE_10_LOW_SIDE: R64.1; also elsewhere on the board
VALVE_11_LOW_SIDE: R65.1; also elsewhere on the board
VALVE_12_LOW_SIDE: R66.1; also elsewhere on the board

Notes on the sheet:
1 (+5V) 1 (MCU) 1 (RPI_IO) 2 (RPI_UART) 2 (RS_485_UART) 18 (drive signals) 4 (24 V sources) ------------ 29 -> 30 total RED LEDS: wurth 0603 150060RS75000 10k resistors for 24V signals CRA04P08310K0JTD 1k for 5V signals

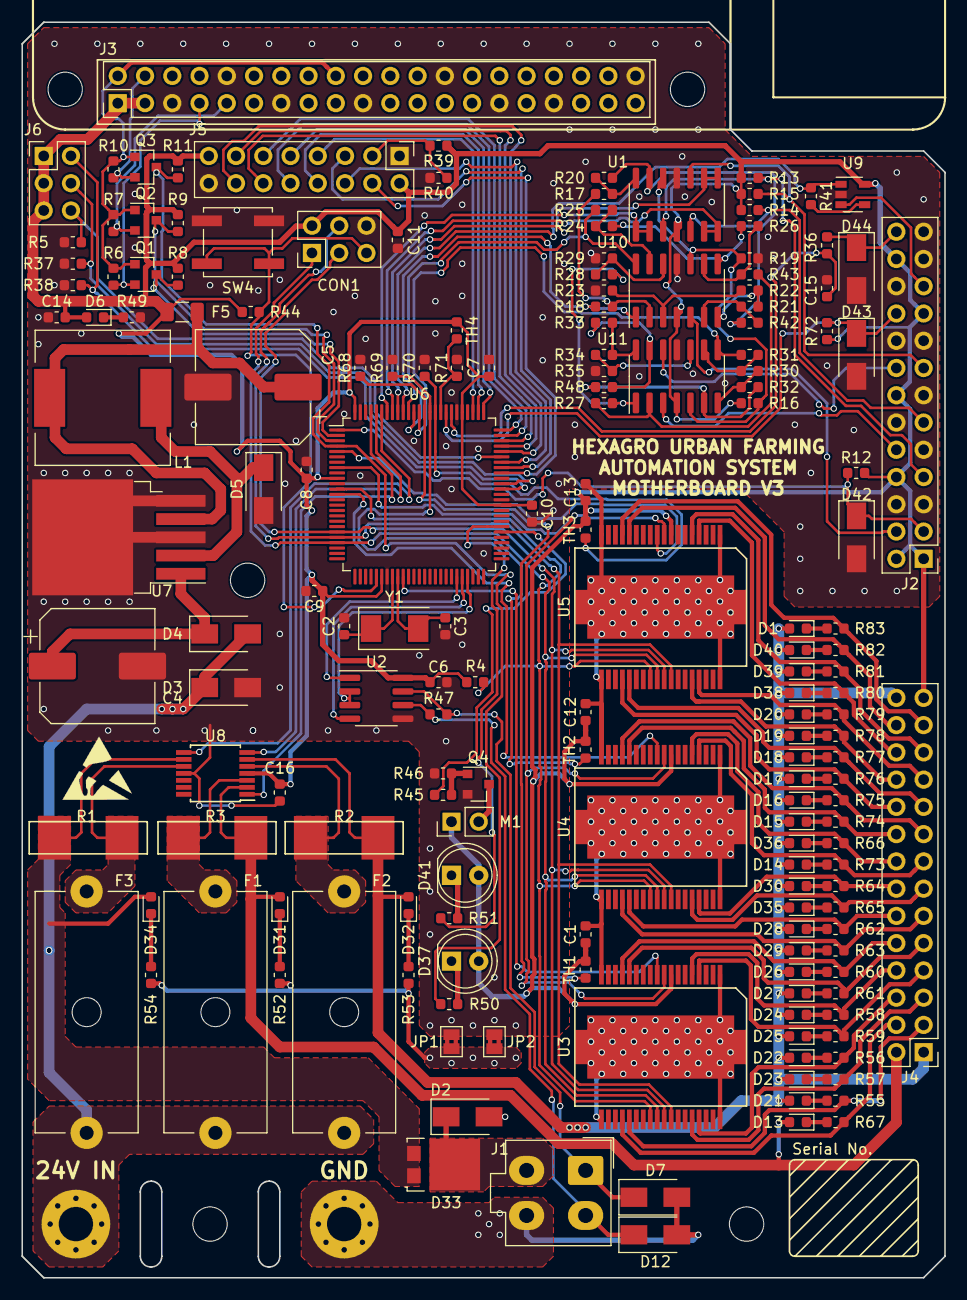
[picture p18: board motherBoard_V2.1.kicad_pcb from above]

Board: 2 copper layers, 86.0 x 117.0 mm, 175 parts (0 on the bottom side), 155 nets.
